seesharp15/cloudline-fan-controller/hardware/pcb/fab/gerbv_copper_bottom.png

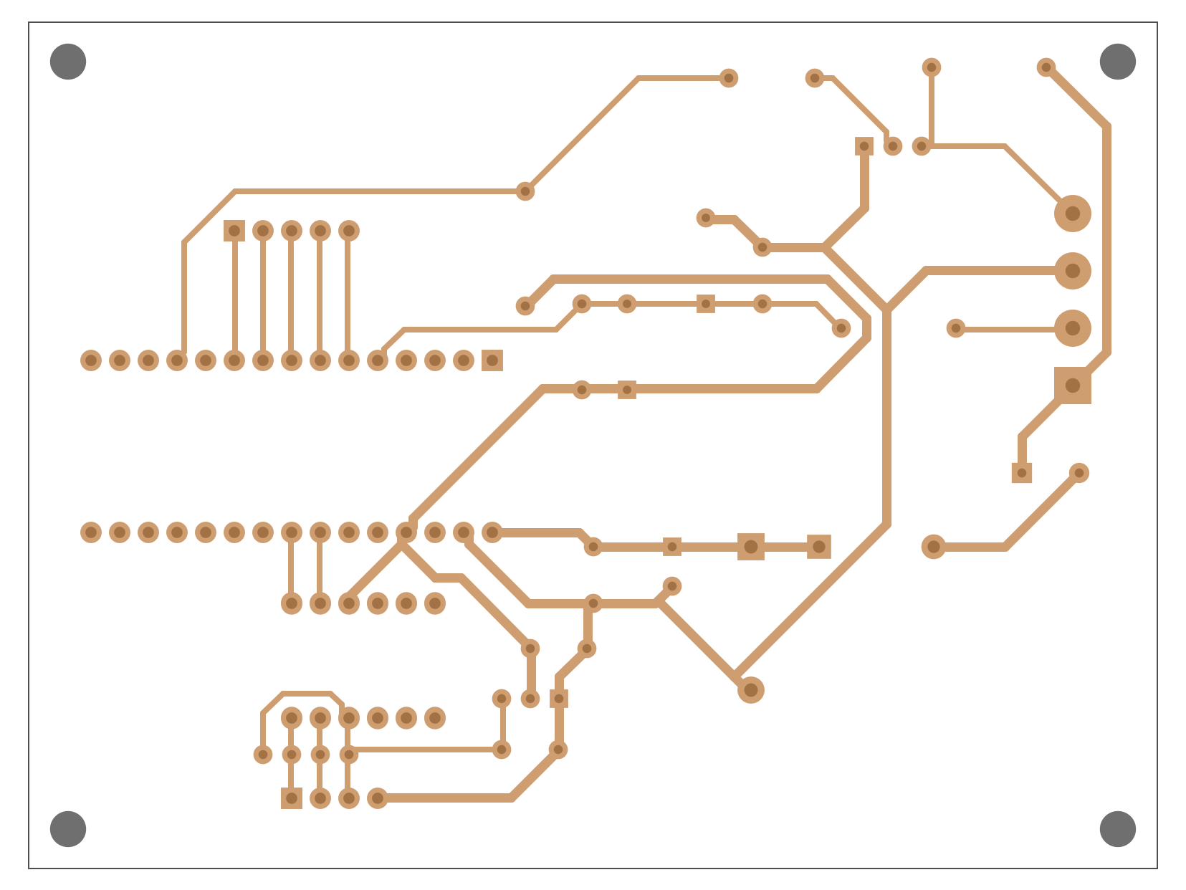
hardware/pcb/fab/gerbv_copper_bottom.png
