seesharp15/cloudline-fan-controller/hardware/pcb/fab/gerbv_silk_top.png

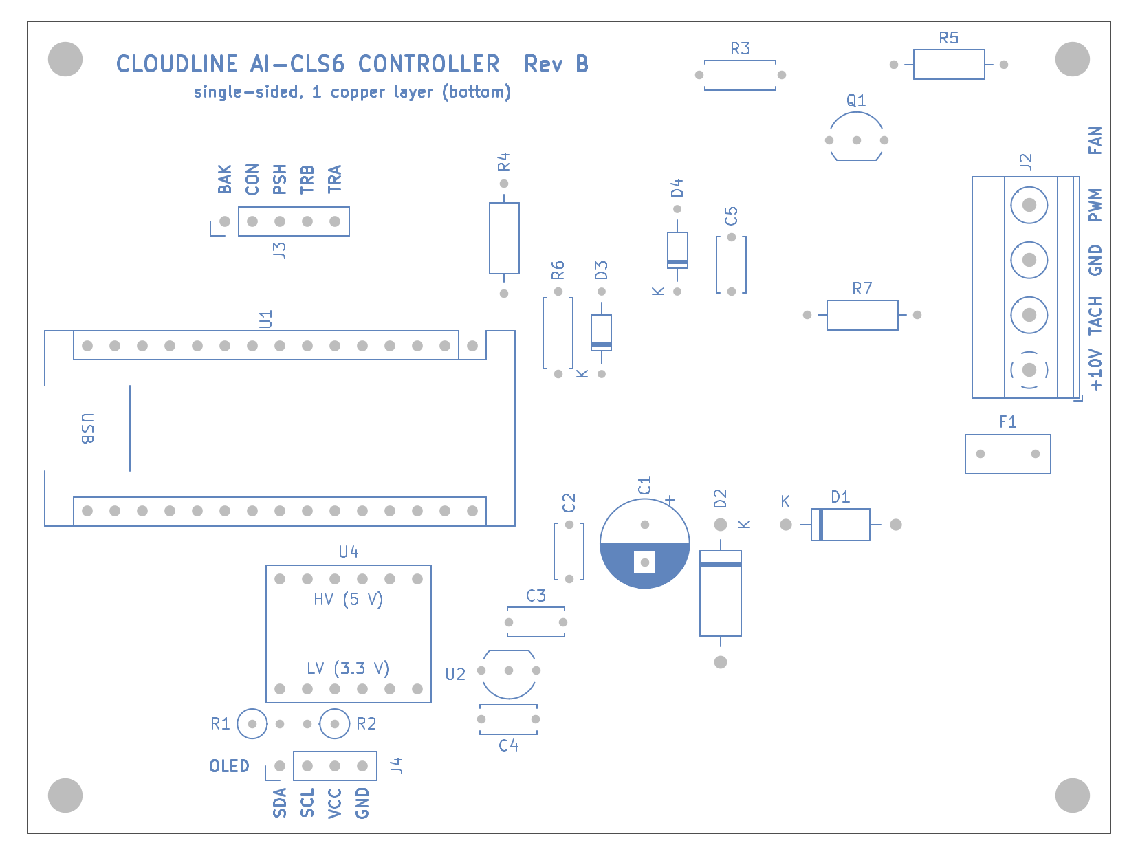
hardware/pcb/fab/gerbv_silk_top.png
