seesharp15/cloudline-fan-controller/hardware/pcb/fusion/isolation_preview.png

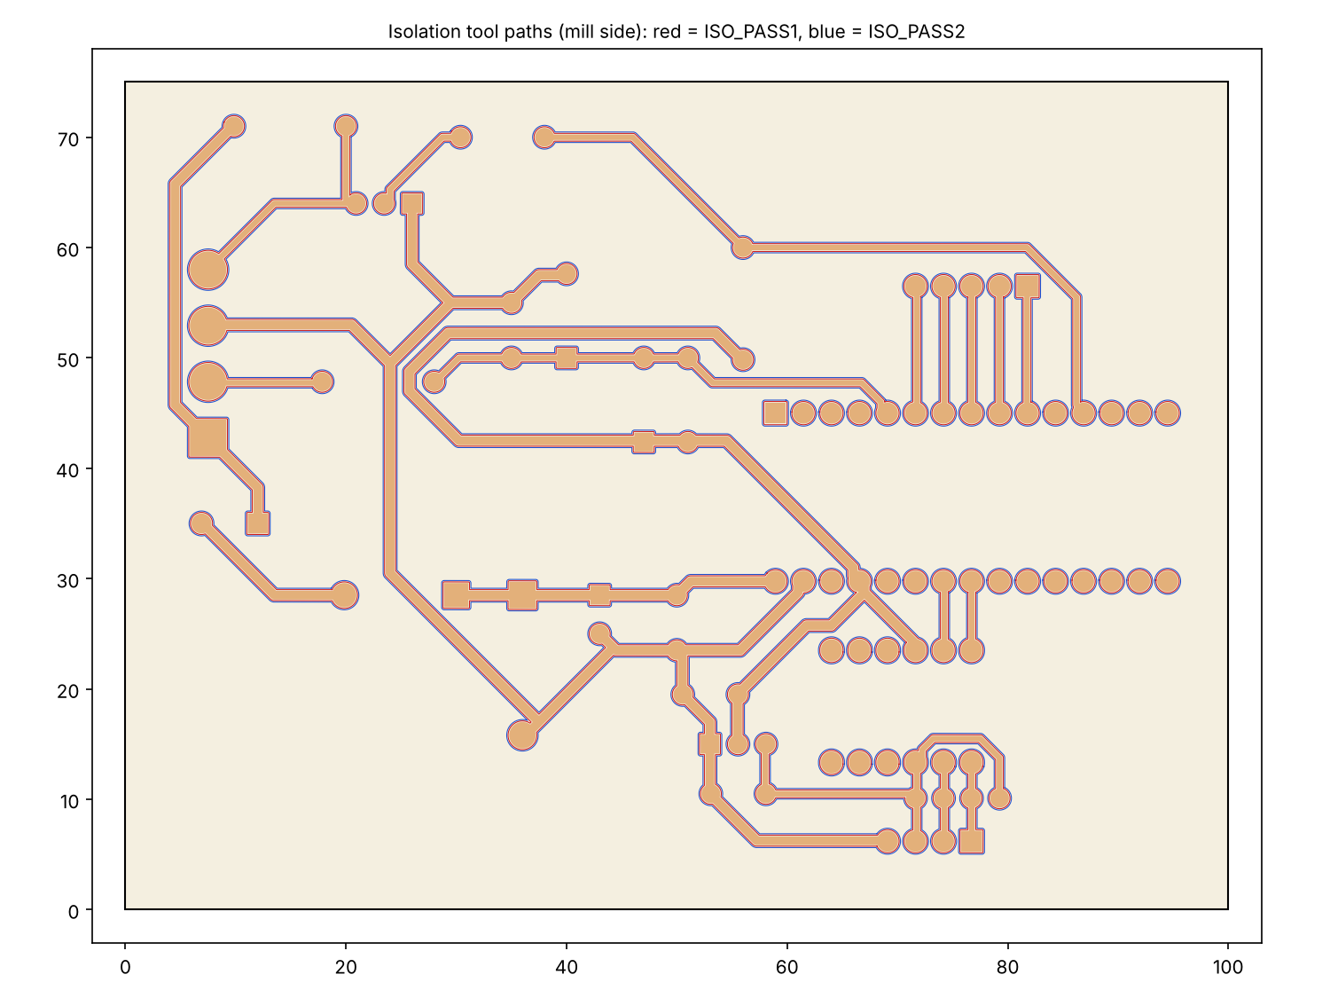
hardware/pcb/fusion/isolation_preview.png
