seesharp15/cloudline-fan-controller/hardware/pcb/fusion/cloudline_pcb_TOPVIEW.step

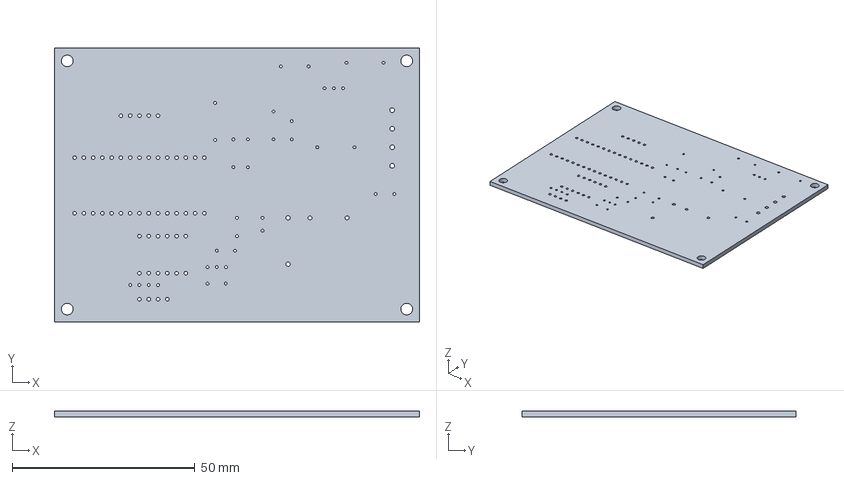
[picture p10: CAD file, 2026-11-03]
hardware/pcb/fusion/cloudline_pcb_TOPVIEW.step
100.0 x 75.0 x 1.64 mm
FR4_substrate
copper_P10V_FAN
copper_P10V_P
copper_P3V3
copper_P5V
copper_nc_U1.11
copper_nc_U1.13
copper_nc_U1.14
copper_nc_U1.15
copper_nc_U1.16
copper_nc_U1.17
copper_nc_U1.18
copper_nc_U1.19
copper_nc_U1.1
copper_nc_U1.20
copper_nc_U1.21
copper_nc_U1.22
copper_nc_U1.25
copper_nc_U1.26
copper_nc_U1.28
copper_nc_U1.2
copper_nc_U1.3
copper_nc_U1.4
copper_nc_U4.GND_HV
copper_nc_U4.GND_LV
copper_nc_U4.HV3
copper_nc_U4.HV4
copper_nc_U4.LV3
copper_nc_U4.LV4
copper_ENC_A
copper_ENC_B
copper_ENC_SW
copper_FAN_PWM
copper_GATE
copper_GND
copper_KEY_BAK
copper_KEY_CON
copper_N_F1_D1
copper_PWM_D9
copper_SCL_3V3
copper_SCL_5V
copper_SDA_3V3
copper_SDA_5V
copper_TACH_5V
copper_TACH_IN
