seesharp15/cloudline-fan-controller/(list of files, cad)

Other CAD files:
hardware/pcb/fusion/cloudline_pcb_MILL_copper_up.step
hardware/pcb/fusion/cloudline_pcb_MILL_copper_up.dxf
