seesharp15/cloudline-fan-controller/hardware/wiring.png

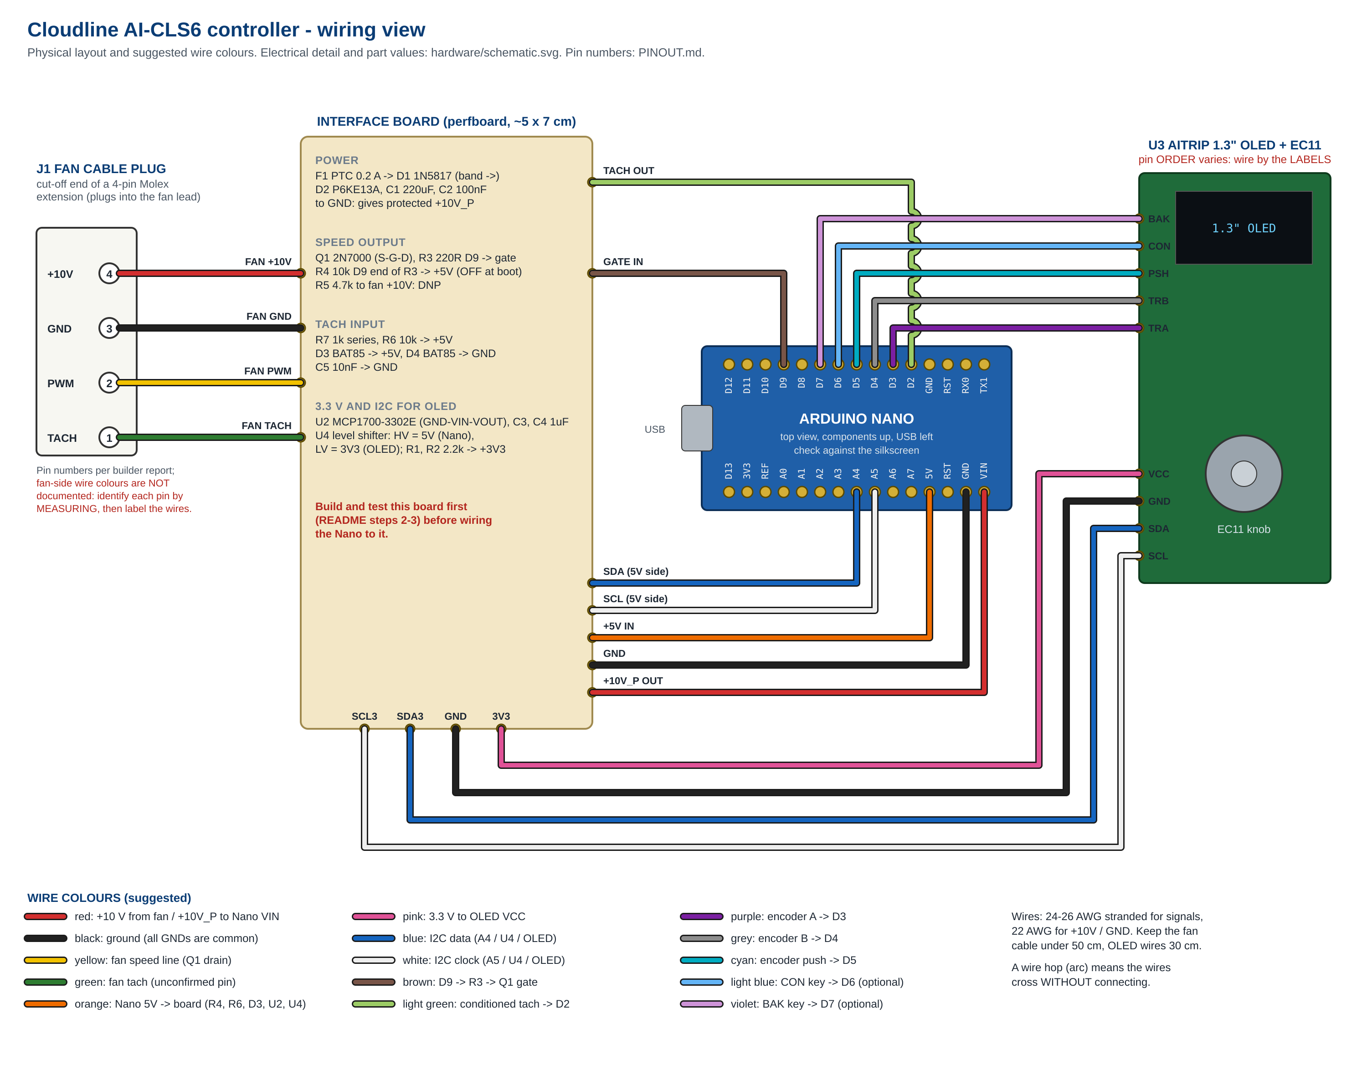
hardware/wiring.png
