seesharp15/cloudline-fan-controller/VERIFICATION.md

# Verification report

What has been checked, how, and what still has to be confirmed on hardware.
Date of this report: 2026-10-28, firmware and hardware **Rev B**.

**Bottom line.** The firmware compiles for the Nano with adequate memory
headroom, its logic passes all host tests, and the real compiled binary boots
and recovers from a hang in an AVR simulator. The circuit values are
calculated below from datasheet limits. **Nothing has been built or run on a
real Nano, OLED module or fan.** The fan-side facts (pinout, signal levels,
tach) come from builder reports, not from AC Infinity, and must be confirmed
with the README's [pre-connection verification](README.md#pre-connection-verification)
and [BENCH_TEST.md](BENCH_TEST.md). This report does not claim the design
will work beyond what that evidence supports.

## Contents

1. [Requirements traceability matrix](#1-requirements-traceability-matrix)
2. [Electrical calculations](#2-electrical-calculations)
3. [Pin assignment cross-check](#3-pin-assignment-cross-check)
4. [Verified versus assumed](#4-verified-versus-assumed)
5. [Hardware assumptions: evidence and status](#5-hardware-assumptions-evidence-and-status)
6. [Known limitations and failure modes](#6-known-limitations-and-failure-modes)
7. [Independent review: findings and fixes](#7-independent-review-findings-and-fixes)
8. [Recorded test and build output](#8-recorded-test-and-build-output)

Requirement IDs: REQ = original brief, DOC = README items, FAQ, ASM =
hardware assumptions (addendum §3), DES = design issues (§4), TST = tests
(§5), VER = this report (§6), SCH = schematic (§7), LAY = layout (§8),
CHK = final checklist (§9). They are deliberately different from part
references (R1, D2, C1 …).

Status legend:

- **PASS**: met and verified by the evidence named (test, compile,
  calculation, inspection).
- **PASS (sim)**: met in software and simulation; hardware confirmation is
  still listed in the "bench" column.
- **HW PENDING**: depends on a fact or behaviour only a physical test can
  confirm.
- **FLAGGED**: cannot be verified from the sources available; documented with
  a procedure for the builder.

---

## 1. Requirements traceability matrix

Code locations are in `firmware/cloudline_controller/` unless a path is
given. "Unit" = `test/test_fan_logic.cpp`, "Sim" = `test/test_firmware_sim.cpp`
scenario, "AVR" = `test/avr/run_simavr.sh`, bench IDs = [BENCH_TEST.md](BENCH_TEST.md).

### 1.1 Original brief (TASK.md)

| ID | Requirement | Code | Schematic | Tests / bench | Status |
|---|---|---|---|---|---|
| REQ-1 | Encoder controls fan speed | `fan_logic.h` `QuadratureDecoder`, `applyDetents`, `Controller::onDetents`; `app.cpp` `ISR(PCINT2_vect)`, `handleEncoder` | U3 TRA/TRB → D3/D4 | Unit `decoder_*`, `detents_*`; Sim `boot1`; bench A6, B4 | PASS (sim) |
| REQ-2 | Encoder button toggles on/off | `fan_logic.h` `Button`, `Controller::onKnob`; `app.cpp` `handleButtons` | U3 PSH → D5 | Unit `button_*`, `controller_on_off_keeps_setting`; Sim `boot1` (incl. bounce); bench A8, B3 | PASS (sim) |
| REQ-3 | Fan off at power-up | `Controller` (`on_ = false`); `app.cpp` `setupFanPwm()` (gate HIGH before OUTPUT), `setup()` | **R4** 10 kΩ, D9 end of R3 → +5V; Q1 | Unit `controller_power_up_state`; Sim `checkPowerUpState` in every scenario; AVR `normal` (duty 0.0 %); bench A4, A5, B1, B2 | PASS (sim); HW PENDING (fan polarity, M4) |
| REQ-4 | Setting persists while powered | `Controller::setting_` (RAM); OFF does not change it | — | Unit `controller_on_off_keeps_setting`; Sim `boot1`, `powercycle`; bench A9, B11 | PASS (sim) |
| REQ-5 | Display: setting and tach speed; on/off status, bars, percentages | `display_ui.h` `drawMain`; `app.cpp` `updateDisplay` | U3 SDA/SCL via U4 | Sim `boot1` text and layout checks on every frame; screenshots `docs/img/`; bench A10, A14, B9 | PASS (sim); ACT % needs a calibration first; tach HW PENDING (ASM-6) |
| REQ-6 | Arduino and OLED powered from the fan's 10 V, with conditioning | — | F1, D1, D2, C1, C2 → VIN; U2, C3, C4 → +3V3 | Calculations §2.1–2.5; bench A1–A3, A13, B1, B10, B13 | PASS (calc); HW PENDING (ASM-2) |
| REQ-7 | Pinout document incl. power supplies | [PINOUT.md](PINOUT.md) §1–§6 | — | `test/check_pins.py` (§3) | PASS |
| REQ-8 | Graphical schematic incl. resistors and transistors | `hardware/schematic.py` → `.svg`/`.png` | all | Inspection (rendered PNG) | PASS |
| REQ-9 | Arduino code | `firmware/cloudline_controller/` | — | Compile §8.4; all tests | PASS |

### 1.2 Addendum §1: README

| ID | Item | Where | Status |
|---|---|---|---|
| DOC-1 | What it does + photo-style overview | README top, `hardware/overview.png` | PASS |
| DOC-2 | BOM: part, qty, value/rating, part number, cost; connectors, wire gauge, heat shrink, enclosure | README *Bill of materials*, `hardware/bom.csv` | PASS |
| DOC-3 | Tools incl. multimeter, USB cable type | README *Tools* | PASS |
| DOC-4 | IDE 2.x, board, pinned library versions, CH340 note, processor setting and how to tell | README *Software setup*, `firmware/libraries.txt` | PASS |
| DOC-5 | Build guide in the required order, each step with a check | README steps 1 verify connector → 2 power conditioning → 3 power test without Nano → 4 OLED/encoder → 5 flash and test on USB → 6 fan interface → 7 first power-up on the fan → 8 enclosure; each ends with "Check before continuing" | PASS |
| DOC-6 | First power-up and expected display | README *Step 7. First power-up on the fan supply* | PASS |
| DOC-7 | Normal operation | README *Normal operation* | PASS |
| DOC-8 | Troubleshooting table with all listed symptoms | README *Troubleshooting* (blank, garbled, encoder skip/backwards, button, full speed when off, won't stop at 0 %, RPM 0/erratic, resets on speed change, upload fails) | PASS |

### 1.3 Addendum §2: FAQ

| ID | Question | Status |
|---|---|---|
| FAQ-1…10 | USB + fan; off at power-up and bootloader window; persistence and how to add it; RPM % and calibration; PWM frequency; other fans; unplugged while running; warranty and damage; Uno/Pro Mini/ESP32; SSD1306 vs SH1106 | PASS: all ten answered in [FAQ.md](FAQ.md), plus six more |

### 1.4 Addendum §3: hardware assumptions

| ID | Assumption | Evidence | Builder check | Status |
|---|---|---|---|---|
| ASM-1 | J1 pinout | §5 ASM-1 | M1, M3, M4, M5 | FLAGGED (builder reports) |
| ASM-2 | Supply voltage and current | §5 ASM-2 | M1, M2 | FLAGGED (voltage reported; current undocumented) |
| ASM-3 | Control signal type, level, frequency; PWM vs 0–10 V | §5 ASM-3 | M3, M4, M4b | FLAGGED (consistent builder reports) |
| ASM-4 | Internal pull-up; floating behaviour | §5 ASM-4 | M3, M3b, M4 | FLAGGED |
| ASM-5 | 0 % stops the fan | §5 ASM-5 | M4, bench B7 | FLAGGED |
| ASM-6 | Tach type, level, PPR | §5 ASM-6 | M5, M5b, bench B5 | FLAGGED (**no source found**) |
| ASM-7 | OLED driver, interface, address | §5 ASM-7 | M7, build step 5 (serial reports the address that answers) | FLAGGED (seller listings) |
| ASM-8 | README pre-connection section with stop rules | README *Pre-connection verification* | — | PASS |

### 1.5 Addendum §4: design issues

| ID | Issue | Code | Schematic | Tests / bench | Status |
|---|---|---|---|---|---|
| DES-1 | Interrupt allocation | `app.cpp` header comment, `onTachPulse` (INT0), `ISR(PCINT2_vect)`; compile-time `#error` checks | D2 tach, D3/D4 encoder | Sim checks INT0 attached, INT1 unused, PCMSK2 = D3/D4; PINOUT §3 | PASS |
| DES-2 | Boot-time fan state, hardware hold-off | `setupFanPwm()` | **R4** 10 kΩ, D9 end of R3 → +5V | Sim `outWhenMadeOutput == HIGH`; calc §2.6; bench A4, A5 | PASS (sim/calc); HW PENDING |
| DES-3 | PWM level shifting into 10 V input; inversion in code | `fan::gateDriveFor`, `FAN_PWM_INVERTED` | **Q1** 2N7000, **R3** 220 Ω, R4, R5 (DNP) | Unit `gate_drive_*`, `polarity_inversion`; Sim duty checks; bench A7 | PASS (sim/calc); HW PENDING (M4) |
| DES-4 | Tach pulled up to 5 V, protected | `onTachPulse` (FALLING); D2 `INPUT_PULLUP` | **R6** 10 kΩ → +5V, **R7** 1 kΩ, **D3/D4** BAT85, **C5** 10 nF | Calc §2.7; README step 6 check (tach node 4.5–5.1 V, 0.45 V when shorted); bench A10, A11 | PASS (calc); HW PENDING |
| DES-5 | Power: VIN regulator vs buck, dissipation at 10 V, reverse polarity, bulk/decoupling, transients, brown-out | — | F1, D1, D2, C1, C2 | Calc §2.2–2.5; FAQ; bench A1–A3, A13, B10 | PASS (calc); HW PENDING |
| DES-6 | Encoder: state machine, no skip/reverse, step and range | `QuadratureDecoder`, `applyDetents`, `ENC_*`, `SETTING_*` in `config.h` | — | Unit `decoder_*` (bounce, rapid reversal, half-step), `detents_at_limits`; Sim bounce | PASS (sim) |
| DES-7 | Button: debounced, one toggle per press | `fan::Button` (25 ms) | — | Unit `button_bounce_gives_one_press`; Sim bounce block in `boot1`; bench A8 | PASS (sim) |
| DES-8 | RPM: window, timeout, % vs calibrated max, calibration method | `TachEstimator`, `smoothRpm`, `rpmToPercent`, `tachFault`, `Controller` calibration; serial `c`/`m` | — | Unit `tach_*`, `rpm_percent*`, `controller_calibration_*`; Sim `boot1`, `calfail`, `serial`; bench A10–A12, B8 | PASS (sim) |
| DES-9 | Display: no flicker, stated rate, layout | `updateDisplay` (10 Hz + on input), page buffer | — | Sim: 95–105 frames per 10 s, layout checks; bench A14 | PASS (sim); flicker HW PENDING |
| DES-10 | Setting in RAM only; no EEPROM writes | no EEPROM code anywhere | — | `make -C test` `no-eeprom`; `avr-nm` shows no EEPROM routines linked (§8.4); Sim `powercycle` | PASS |
| DES-11 | Watchdog; documented reset behaviour | `watchdogStart` (started at the top of `setup()`), `ISR(WDT_vect)` (fan off, interrupt sources off, setting saved, `jmp 0`), `earlyResetHandling` (`.init3`) | R4 keeps fan off during any reset | AVR `hang` (recovery, fan off, setting 37 % kept, `reset=0x80`); Sim feed count; FAQ; bench W1, W2 | PASS (AVR sim); interrupts-off path per datasheet, HW PENDING (W2) |
| DES-12 | Every tunable in a labelled config block | `config.h`, a separate tab included first by the sketch, headed "CONFIGURATION BLOCK" (the addendum says "at the top of the sketch"; a separate file keeps it the only file to edit, and §8 lists "sketch, config" separately) | — | Inspection | PASS (as a separate file) |

### 1.6 Addendum §5–§9

| ID | Item | Evidence | Status |
|---|---|---|---|
| TST-1 | Pure logic separated from hardware | `fan_logic.h` has no Arduino calls; `app.cpp` glue only | PASS |
| TST-2 | Host unit tests incl. listed edge cases | `test/test_fan_logic.cpp`: encoder at min/max (`detents_at_limits`), rapid direction changes, button bounce, tach timeout, divide-by-zero, max RPM not calibrated | PASS |
| TST-3 | Tests run, output included | §8.1–8.3 | PASS |
| TST-4 | arduino-cli compile with flash/RAM; RAM headroom | §8.4; §2.11 | PASS |
| TST-5 | Wokwi simulation, can/can't | `sim/`; [sim/README.md](sim/README.md). **Not run**: wokwi.com unreachable from the build environment; stated in sim/README. | PARTIAL (prepared, compiles, not executed) |
| TST-6 | BENCH_TEST.md, dummy load then real fan | [BENCH_TEST.md](BENCH_TEST.md) Parts A and B | PASS |
| TST-7 | State what is not possible | sim/README (Wokwi not run), §4, test/avr/README (simavr watchdog limit) | PASS |
| VER-1…6 | This report: matrix, calculations, pin cross-check, verified vs assumed, limitations, review findings | §1–§7 | PASS |
| SCH-1 | Schematic SVG + PNG from editable source | `hardware/schematic.py` → `schematic.svg`, `schematic.png` | PASS |
| SCH-2 | Ref + value on every part; connector pins from mating side, side stated | schematic; J1 face view box | PASS |
| SCH-3 | Wiring view with wire colours | `hardware/wiring.svg/.png` | PASS |
| LAY-1 | Repository layout | README *Development and tests* | PASS |
| CHK-1 | Final checklist | end of the delivery message | PASS |

### 1.7 Single-sided PCB (request of 2026-11-03)

| ID | Item | Evidence | Status |
|---|---|---|---|
| PCB-1 | PCB with only one copper trace layer | `hardware/pcb/cloudline_controller.kicad_pcb`: every track and pad on B.Cu, no wire links; F.Cu is KiCad's (empty) *jumper* layer and is not exported | PASS |
| PCB-2 | Realises the schematic | `hardware/pcb/check_pcb.py`: copper-geometry connectivity vs. PINOUT §6, 20 nets / 71 pads, 0 opens / 0 shorts (mutation-tested) | PASS |
| PCB-3 | Manufacturable | KiCad DRC: 0 errors, 0 unconnected (22 intentional library-mismatch warnings); gerbv reads the Gerbers back; independent review: no blockers, findings fixed (below) | PASS (not yet fabricated) |
| PCB-4 | All files for production | `hardware/pcb/fab/`: Gerber + drill zip with `FAB_NOTES.txt`, drill map, BOM, assembly drawing, toner-transfer artwork; ordering options in `hardware/pcb/README.md` | PASS |

**Independent review of the PCB (2026-11-03).** A separate agent reviewed the
board, the footprints against the real parts (pin orders, polarities, lead
pitches, the BOB-12009 against SparkFun's Eagle file), the mechanics, the
fab package and the documentation. It confirmed:

- the Nano pin mapping;
- the TO-92 and diode orientation, and C1's polarity;
- the BOB-12009 footprint;
- all lead pitches except F1's;
- the J2/J3/J4 labels against their nets;
- the J2 wire-entry direction;
- the clearances and the fab layers.

It found no blockers. Its findings were:

| # | Sev. | Finding | Resolution |
|---|---|---|---|
| P-1 | Major | The 100 × 75 mm board doesn't fit the enclosure in the BOM, and the BOM and README gave different box sizes. | No inside dimensions could be verified for the listed box, so the BOM and README now state the required **inside** size (115 × 90 × 35 mm for the PCB) and standoff mounting through the board's own holes. |
| P-2 | Major | A 1-layer order doesn't tell the fab that the copper is on the bottom and the legend on top; the file attributes said "L2" and "Plated". | `FAB_NOTES.txt` in the zip, order-remark text in the PCB README, attributes rewritten to `Copper,L1,Bot` and `NonPlated`. |
| P-3 | Minor | Wire link W1 only grounded U4's GND, which the BOB-12009 doesn't use (its GND pins connect only to each other in SparkFun's board file). | U4's GND left unwired; **the board now has no wire links**. |
| P-4 | Minor | F1 footprint (Bel Fuse 0ZRE) has its second pad offset 1.6 mm sideways; the MF-R020 has straight leads. | New `PTC_Radial_P5.10mm` footprint, pads 5.1 mm apart in line. |
| P-5 | Minor | TO-92 footprints have 2.54 mm pitch; straight-lead parts have 1.27 mm. | Assembly note and BOM note: bend the outer leads out. |
| P-6 | Minor | Connector pin labels 0.8 mm / 0.12 mm stroke, below typical fab minimums. | 1.0 mm, 0.16 mm stroke. |
| P-7 | Minor | J4's label was one string beside pin 4. | One label per pin, as on J3. |
| P-8 | Minor | J2 pads (2.6 mm) on unplated holes may lift under screw torque. | 3.3 mm pads; cable gland recommended. |
| P-9 | Minor | PCB README errors: `check_pins.py` doesn't read the PCB; the assembly drawing had no pads; "R4 bridges tracks" was untrue; Adafruit 757 offered without a footprint check. | All corrected; the assembly drawing now includes the pads (B.Mask). |

After these fixes the board was regenerated and DRC, `check_pcb.py`, the
host tests and the fab package were re-run (results above). The fixes were
not reviewed again by a separate agent.

---

## 2. Electrical calculations

Datasheet values are the manufacturers' limits for the parts in the BOM.
"Typ" means a typical figure; worst cases use the limits.

### 2.1 Current budget (+10 V input)

| Load | Current | Basis |
|---|---|---|
| ATmega328P, 16 MHz, 5 V, active | ≈ 10 mA | Datasheet active-supply-current curve (~9–12 mA) |
| CH340 USB chip (idle, no USB) | 3–15 mA | Varies by clone; estimate |
| Nano power LED | ≈ 3 mA | 5 V through ~1 kΩ |
| D13 LED (fan ON) | ≈ 3 mA | 5 V through ~1 kΩ |
| OLED module | 5–20 mA | Depends on lit pixels (these screens light ~20–35 %); estimate |
| R4 (D9 low, fan running) | 0.5 mA | 5 V / 10 kΩ |
| R6 (tach low) | ≤ 0.5 mA | 5 V / 11 kΩ |
| R1/R2 (I²C low) | ≤ 1.5 mA each, while bits are low | 3.3 V / 2.2 kΩ |
| U4 module pull-ups (I²C low) | ≤ 0.8 mA per line, while bits are low | 10 kΩ to 5 V and to 3.3 V |
| U2 quiescent | 1.6 µA | MCP1700 datasheet |
| **Total** | **≈ 25–55 mA; design figure 60 mA** | |

### 2.2 Input chain

- **F1** Bourns MF-R020: hold 0.20 A, trip 0.40 A, 60 V. Resistance a few
  ohms (rises after a trip). At 60 mA: drop 0.1–0.5 V. Normal load is under
  a third of the hold current, which leaves room for derating at 40–50 °C.
- **D1** 1N5817: V<sub>RRM</sub> 20 V (> 10 V, so reverse polarity is
  blocked), forward drop ≈ 0.3 V at 60 mA (datasheet V<sub>F</sub> curve).
- **VIN** = 10 − (0.1…0.5) − 0.3 ≈ **9.2–9.6 V** at full load; the README
  uses "M1 minus 0.2–0.7 V".
- **D2** P6KE13A: V<sub>RWM</sub> 11.1 V (no conduction at 10 V; leakage
  ≤ 5 µA), V<sub>BR</sub> 12.4–13.7 V, clamps short surges. A sustained
  over-voltage makes it conduct hard so F1 trips (0.4 A).
  **Caveat:** its clamping voltage at high surge current (18.2 V at 33 A)
  is above the AMS1117's 15 V absolute maximum (clone Nanos); genuine Nanos
  use regulators rated to 20 V. A surge of that size from a fan's internal
  10 V supply through F1 and the cable is not expected; this is a residual
  risk, not a calculated margin.
- **C1** 220 µF / 25 V: bulk and hold-up (§2.4). **C2** 100 nF at VIN:
  high-frequency decoupling.

### 2.3 Regulator dissipation (Nano 5 V regulator) — at 10 V input

Worst case taken literally at **10 V on VIN** (ignoring the D1/F1 drops):

P = (V<sub>IN</sub> − 5 V) × I = (10 − 5) × 0.060 = **0.30 W**
(0.28 W at the realistic 9.6 V).

The regulator is an AMS1117-5.0 (clones) or LM1117 (genuine) in SOT-223.
With the Nano's small copper area, θ<sub>JA</sub> ≈ 90–110 °C/W (datasheet
range for minimum pad), so the rise is **27–33 °C**: T<sub>J</sub> ≈ 73 °C
at 40 °C ambient, against a 125 °C maximum. Dropout ≈ 1.1–1.2 V, so it
regulates down to **V<sub>IN</sub> ≈ 6.2 V**.

**Buck vs linear:** a buck at ~85 % efficiency would take about 0.35 W
instead of 0.6 W from the fan, saving ~0.25 W, but adds switching noise next
to the tach input and another module. The linear regulator is within limits,
so it was kept (FAQ). Above ~100 mA or 12 V input a buck would be preferable.

**U2** MCP1700-3302E: (5 − 3.3) × 0.020 = 34 mW; V<sub>IN</sub> max 6 V
(> 5 V rail); dropout 178 mV typ at 250 mA; needs ≥ 1 µF ceramic in and out
(C3, C4).

### 2.4 Hold-up and brown-out

- D1 stops C1 discharging back into the fan's supply when it dips.
- Time C1 can hold the regulator in regulation at 60 mA, from 9.6 V down to
  6.2 V: t = C × ΔV / I = 220 µF × 3.4 V / 0.060 A = **12.5 ms**.
- If the 5 V rail does collapse, the ATmega's brown-out detector (Nano
  fuses: extended 0xFD = BOD 2.7 V) holds it in reset; D9 floats and R4
  keeps Q1 on while the rail is above Q1's threshold (§2.6). Below about 3 V
  on the 5 V rail Q1 can't be held on and the fan line is released: this
  requires the fan's own 10 V to have collapsed below ~4 V (bench A13).

### 2.5 Reverse polarity and transients summary

| Event | Result |
|---|---|
| J1 +10 V / GND swapped | D1 blocks (20 V rating). No current. |
| Spike on +10 V | D2 clamps; C1/C2 absorb short ones |
| Sustained over-voltage > 12.4 V | D2 conducts, F1 trips at ≥ 0.4 A, resets when it cools |
| Controller short | F1 limits to < 0.4 A sustained |

### 2.6 Speed output: Q1 2N7000 (open drain)

| Quantity | Value | Basis |
|---|---|---|
| Gate drive | V<sub>GS</sub> = 5 V (D9 high, or R4 during reset) | ATmega V<sub>OH</sub> ≥ 4.2 V at 20 mA; static gate current ≈ 0 |
| Threshold | V<sub>GS(th)</sub> 0.8–3.0 V | onsemi 2N7000 datasheet |
| On-resistance | R<sub>DS(on)</sub> ≤ 5.3 Ω at V<sub>GS</sub> 4.5 V | onsemi datasheet |
| Line current | I = V<sub>pull-up</sub> / R<sub>pull-up</sub> ≤ 10 V / 1 kΩ = 10 mA (M3b measures R) | |
| Line "low" | V<sub>DS</sub> ≤ 10 mA × 5.3 Ω = **53 mV** | "Stopped" level |
| Q1 dissipation | ≤ 0.5 mW | |
| D9 peak current | 5 V / (220 Ω + ~25 Ω pin) ≈ **20 mA** < 40 mA abs. max | R3 |
| Gate time constant | 245 Ω × C<sub>iss</sub> ≤ 60 pF ≈ **15 ns** | ≪ 250 µs period at 4 kHz |
| R4 current while D9 low | 5 V / 10 kΩ = 0.5 mA | |
| R5 (if fitted) | 10 V / 4.7 kΩ = 2.1 mA, 21 mW | |
| Line duty (inverted) | gate duty = 1000 ‰ − line duty | `gateDriveFor` |
| PWM | Timer1 mode 14, TOP = 16 MHz / 4 kHz − 1 = 3999 → **4000 Hz, 4000 steps** | Sim checks ICR1 = 3999 |
| Line rise time | τ = R<sub>pull-up</sub> × C<sub>line</sub>; e.g. 100 kΩ × 300 pF = 30 µs (12 % of a period) | Unknown R: M3b |

### 2.7 Tach input (5 V pull-up, series resistor, clamps)

ATmega328P at 5 V: **V<sub>IL</sub> max = 0.3 V<sub>CC</sub> = 1.5 V,
V<sub>IH</sub> min = 0.6 V<sub>CC</sub> = 3.0 V**; inputs have Schmitt
triggers.

| Fan's tach pin state | D2 voltage | Margin |
|---|---|---|
| Open collector sinking (V<sub>CE(sat)</sub> ≤ 0.4 V) | 0.4 + 4.6 × 1k/11k = **0.82 V**; with the AVR's internal pull-up (≥ 20 kΩ) also on, R6‖20k = 6.7 kΩ: 0.4 + 4.6 × 1k/7.7k = **1.0 V** worst case | ≥ 0.5 V below V<sub>IL</sub> |
| Open collector released | 5.0 V through R6 | 2.0 V above V<sub>IH</sub> |
| Push-pull 3.3 V high | 3.3 + 1.7 × 1k/11k = **3.45 V** | 0.45 V above V<sub>IH</sub> |
| Push-pull 10–12 V high | clamped by D3 to ≈ 5.3 V; current (12 − 5.3) / 1 kΩ = **6.7 mA** | BAT85 I<sub>F</sub> max 200 mA; the 5 V rail's ≥ 25 mA load absorbs it |
| Negative spike | clamped by D4 to ≈ −0.3 V | |
| Nothing connected | 5.0 V; no edges; NO TACH after 8 s | |

- Filter: R6‖R7 ≈ 0.91 kΩ × 10 nF ≈ **9 µs** on falling edges; release
  (rising) through R6: 10 kΩ × 10 nF = 100 µs, reaching V<sub>IH</sub> in
  ≈ 92 µs. Tach periods are milliseconds (up to 1 kHz is accepted:
  `TACH_MIN_PERIOD_US` 1000 = 30 000 RPM at 2 PPR).
- Firmware: falling edges on INT0, glitch rejection < 1 ms, RPM from period
  over a 500 ms window, 0 RPM after 1.5 s without edges. D2 also has the
  AVR's internal pull-up on, so it is defined before R6 is fitted (build
  step 5).

### 2.8 I²C and module inputs

The ATmega328P's two-wire interface needs **V<sub>IH</sub> ≥ 0.7 V<sub>CC</sub>
= 3.5 V** (datasheet, two-wire serial interface characteristics), stricter
than the 0.6 V<sub>CC</sub> of general I/O. A 3.3 V pull-up therefore does not
meet the datasheet, and a 5 V pull-up would put 5 V on the SH1106 (V<sub>DD</sub>
3.3 V). Rev B adds **U4**, a BSS138 bidirectional level shifter (SparkFun
BOB-12009: one BSS138 per channel, 10 kΩ pull-ups to HV and LV):

| Side | Pull-up | High level | Low level | Rise time (30→70 %) |
|---|---|---|---|---|
| Nano (HV, 5 V) | U4 10 kΩ ‖ AVR internal 20–50 kΩ ≈ 7 kΩ | 5 V ≥ 3.5 V ✓ | via BSS138 from the LV side, < 0.4 V | short on-board wires, ~20 pF: 0.85 × 7 kΩ × 20 pF ≈ **120 ns** |
| Display (LV, 3.3 V) | R1/R2 2.2 kΩ ‖ U4 10 kΩ ≈ 1.8 kΩ (‖ module pull-ups, if any) | 3.3 V | SH1106 or BSS138; the device pulling low also sinks the 5 V side's pull-up current through the BSS138: 3.3 V / 1.8 kΩ + 5 V / 7 kΩ ≈ **2.5 mA** (I²C limit 3 mA). With extra ≤ 4.7 kΩ pull-ups on the module it would be ≈ 3.2 mA, so R1/R2 are left out in that case (README M7). | module wires, ~100 pF: 0.85 × 1.8 kΩ × 100 pF ≈ **150 ns** |

Both are below the 300 ns fast-mode limit at the 400 kHz clock. (Rev A had
4.7 kΩ to 3.3 V directly on the Nano pins: ≈ 400 ns and a 3.3 V high
below V<sub>IH</sub>; review finding 6 and self-found S-1.)

The `Wire` timeout is enabled in `setup()` (25 ms, with TWI reset), so a
single transfer can't block. A stuck bus would still make a whole display
operation slow (U8g2's `begin()` is ~165 transfers ≈ 4 s of timeouts, more
than the 2 s watchdog), so the firmware drives the display **only while it
answers**: `startDisplay()` probes the address first (one 25 ms timeout at
most) and skips `begin()` if there's no answer; each page of a frame is
followed by a timeout check that stops drawing after at most one page
(8 transfers ≈ 200 ms); the display is probed again every 5 s. The timeout's
TWI reset re-enables the AVR's internal 5 V pull-ups, which is harmless on
U4's 5 V side. Sim scenario `nodisplay` covers a missing display, a late
display and a mid-run bus failure.

Encoder/keys: switches to GND with the AVR's 5 V internal pull-ups; assumed
not to connect to the SH1106 (README check M7).

### 2.9 Timing and CPU load

- Display: page buffer, 4 passes per frame, 1 KB at 400 kHz ≈ 25–30 ms per
  frame (estimate). 10 Hz refresh ≈ 30 % of the time. Encoder and tach are
  interrupt-driven, so no edges are lost during transfers.
- Worst `loop()` pass, display working: ≈ one frame (< 50 ms). Display
  failing: one page of timeouts (≈ 200 ms) once, then 25 ms probes every
  5 s. Both ≪ 2 s watchdog.

### 2.10 Logic level summary

| Signal | Driver | Receiver | Levels |
|---|---|---|---|
| D9 → Q1 gate | ATmega 0/5 V | 2N7000 V<sub>th</sub> ≤ 3 V | 5 V ≥ 3 V + margin |
| Q1 drain → fan | open drain | fan input (pull-up to ~10 V) | 0.05 V / released |
| Fan tach → D2 | OC or push-pull | ATmega Schmitt input | ≤ 0.82 V / ≥ 3.45 V |
| SDA/SCL, Nano side | open drain, 5 V pull-ups (U4 HV) | ATmega TWI (V<sub>IH</sub> 3.5 V) | 0 / 5 V |
| SDA/SCL, display side | open drain, 3.3 V pull-ups (R1/R2, U4 LV) | SH1106 | 0 / 3.3 V |
| Encoder/keys → D3–D7 | switch to GND | ATmega + 5 V internal pull-up | 0 / 5 V |

### 2.11 Memory

| | Used | Limit | Headroom |
|---|---|---|---|
| Flash | 26 236 B | 30 720 B | 4 484 B (15 %) |
| Static RAM | 1 287 B | 2 048 B | 761 B for stack |
| Stack, estimated | ≈ 360 B | | deepest path: `loop` 11 + `updateDisplay` 56 + `drawDiagnostics` 67 + `vfprintf` + U8g2 + one ISR frame (`-fstack-usage`) |
| Stack, measured | min. 561 B never touched | | simavr run with the display code forced on, main screen (§8.3) |

The full 1 KB frame buffer was tried first and **does not fit** (2 044 B
static, 4 B left): the firmware uses the 256-byte page buffer
(`OLED_PAGE_BUFFER 1`).

---

## 3. Pin assignment cross-check

`python3 test/check_pins.py` (also run by `make -C test`) parses
`config.h`, `hardware/schematic.py` (Nano pin labels, physical numbers and
the wires to the module), `hardware/wiring.py`, PINOUT.md and README.md, and
fails on any disagreement. A deliberate mutation (D4 → 8 in `config.h`) was
detected. Result: **72 checks, 0 mismatches** (§8.5).

| Signal | Nano pin (physical) | config.h | PINOUT.md | Schematic | Wiring view | README |
|---|---|---|---|---|---|---|
| Tach | D2 / INT0 (5) | `PIN_TACH 2` | ✓ | ✓ D2 / INT0, 5 | ✓ green → D2 | ✓ Step 6 |
| Encoder A | D3 (6) | `PIN_ENC_A 3` | ✓ TRA | ✓ wired to TRA | ✓ purple TRA → D3 | ✓ Step 4 |
| Encoder B | D4 (7) | `PIN_ENC_B 4` | ✓ TRB | ✓ wired to TRB | ✓ grey TRB → D4 | ✓ Step 4 |
| Push switch | D5 (8) | `PIN_ENC_SW 5` | ✓ PSH | ✓ wired to PSH | ✓ cyan PSH → D5 | ✓ Step 4 |
| CON key | D6 (9) | `PIN_KEY_CON 6` | ✓ CON | ✓ wired to CON | ✓ light blue → D6 | ✓ Step 4 |
| BAK key | D7 (10) | `PIN_KEY_BAK 7` | ✓ BAK | ✓ wired to BAK | ✓ violet → D7 | ✓ Step 4 |
| Fan PWM | D9 / OC1A (12) | `PIN_FAN_PWM 9` | ✓ | ✓ D9 / OC1A, 12 | ✓ brown → D9 | ✓ Step 6 |
| Status LED | D13 (16) | `PIN_STATUS_LED 13` | ✓ | on-board (note) | — | — |
| SDA | A4 (23) → U4 HV1/LV1 → module SDA | fixed TWI | ✓ | ✓ A4 / SDA, 23, via U4 | ✓ blue → A4, board → SDA | ✓ Step 4 |
| SCL | A5 (24) → U4 HV2/LV2 → module SCL | fixed TWI | ✓ | ✓ A5 / SCL, 24, via U4 | ✓ white → A5, board → SCL | ✓ Step 4 |
| VIN | VIN (30) | — | ✓ | ✓ 30 | ✓ red → VIN | ✓ Step 2 |
| +5V | 5V (27) | — | ✓ | ✓ 27 | ✓ orange → 5V | ✓ Step 4 |
| GND | GND (29, 4) | — | ✓ | ✓ 29, 4 | ✓ black → GND | ✓ Step 2 |
| J1 pins | 4 +10V, 3 GND, 2 PWM, 1 TACH | — | ✓ | ✓ | ✓ | ✓ M1–M5 |

D8 (`PIN_SIM_TACH_OUT`) is used only in the Wokwi build and appears only in
PINOUT.md, config.h and `sim/diagram.json`.

---

## 4. Verified versus assumed

### Verified

| What | How |
|---|---|
| Firmware compiles for the Nano (both processor settings) and for Wokwi, no warnings from project files | arduino-cli 1.1.1, ArduinoCore-avr 1.8.6, avr-gcc 7.3.0, U8g2 2.35.30 (§8.4) |
| Flash and RAM fit, with stack headroom | size report; `-fstack-usage`; simavr stack paint (§2.11) |
| No EEPROM code | grep check and `avr-nm` of the linked ELF |
| Logic: encoder, button, duty mapping, inversion, Timer1 values, tach maths, timeout, % and guards, controller state machine, calibration, serial parser | 1 113 unit checks, C++11 and C++17 (§8.1) |
| Whole sketch behaviour, screen content and layout, power-up state, millis() wrap | 8 simulation scenarios, 1 451 checks, 1 225 frames layout-checked (§8.2) |
| Real AVR binary boots, prints status, keeps the fan at 0 %; watchdog-interrupt recovery with the fan forced off and the setting kept | simavr (§8.3) |
| Pin numbers agree in all documents | `check_pins.py` (§3) |
| Watchdog second-timeout reset when the interrupt can't run | ATmega328P datasheet (WDTCSR bit WDIE); **not** reproducible in simavr |
| Circuit values against part limits | §2 calculations from datasheet figures |

### Assumed: must be confirmed on hardware

| Assumption | Confirmed by |
|---|---|
| J1 pin functions (4 = +10 V, 3 = GND, 2 = PWM, 1 = tach?) | M1, M3–M5 |
| The port supplies ≥ 60 mA without sagging | M2, bench B1, B13 |
| Line low = stop, released = full; open-drain at 4 kHz works | M4, bench B3, B4, B7 |
| A tach exists on pin 1, its type and pulses per revolution | M5, bench B5 (no published source) |
| Module is SH1106, I²C 0x3C, works on 3.3 V; encoder pins are plain switches | M7, build step 5 (serial address report) |
| EC11 is 20 pulses / 20 detents (4 edges per click) | build step 5 |
| The real display has no visible flicker with the page buffer | bench A14 |
| Brown-out behaviour with the real fan supply | bench A13, B10 |
| Length of the power-up window before R4 can hold Q1 on (FAQ) | bench A4 (scope), B2 |
| U4 level shifter at 400 kHz with the real wiring | build step 5 |
| Thermal behaviour in the enclosure | bench B13 |
| Wokwi diagram runs as described | not run (sim/README) |

---

## 5. Hardware assumptions: evidence and status

Each assumption, the best evidence found, and the builder's check. Sources
are linked in the README *Sources* section. "Builder report" means a hobbyist
forum post or repository, not a manufacturer document.

### ASM-1. Connector and pinout

- **Assumption:** the control port is a PC-peripheral-style 4-pin "Molex"
  (8981 family, 5.08 mm), **not** a 4-pin PC fan header. Pin 4 = +10 V,
  3 = GND, 2 = PWM (speed), 1 = tach (unconfirmed), numbered left to right
  with the chamfered corners up, looking at the fan lead.
- **Evidence:** RollItUp T6/Hyperfan thread (pin 4 = +10 VDC, 3 = GND,
  2 = PWM, 1 = "not used"; chamfer up, left to right); chriskoz/AutoFan for
  the S6 ("4-pin molex ATX HDD connector", "10V / GND / PWM", 4th pin N/C);
  RollItUp ESP32 guide ("same Molex connector used in PC's power supply to
  disks"); AC Infinity manual (fan has "a molex connector"). The 5.08 mm
  pitch follows from the connector family, not from a source.
- **Caveat:** newer S6 units and the PRO line use a USB-C ("UIS") port with
  a different pinout (coofercat/ha-ac-infinity-fan).
- **Check:** M1 (supply and ground, mirror numbering if negative), M3, M4,
  M5. Wire colours are not documented: identify by measuring.

### ASM-2. Supply voltage and current

- **Assumption:** ~10 V DC on pin 4; enough current for ~60 mA.
- **Evidence:** voltage: several builder reports ("10V source ... provided
  by the CL itself", "the fan's 10V instead of 12V ... enough to power the
  Shelly and a few LEDs"). Current: **no source**; one builder reports
  trouble when several channels were powered from it.
- **Check:** M1 (9.5–10.5 V), M2 (≤ 0.5 V drop at 45 mA). Fallback: separate
  adapter (FAQ).

### ASM-3. Control signal

- **Assumption:** PWM by pulling an internally pulled-up ~10 V line to
  ground (open drain); not 0–10 V analogue. Stock controller ≈ 4 kHz.
- **Evidence:** chriskoz ("controlled by grounding and opening the 10V
  control wire", period ~245 µs); ESPHome builds with `inverted: true` and a
  MOSFET to GND at 1 kHz; coofercat (~5 kHz on the USB-C model).
- **If it is actually 0–10 V analogue:** an analogue input would respond to
  the average voltage, which the open-drain PWM also provides; if a fan
  needed a smooth DC level, an RC filter (e.g. 10 kΩ + 10 µF) after Q1's
  drain would be added. Detect: M4 behaves the same; bench A7 levels.
- **Check:** M3, M4.

### ASM-4. Internal pull-up and floating behaviour

- **Assumption:** pulled up inside the fan to about its supply voltage; the
  fan runs at full speed when the line floats.
- **Evidence:** chriskoz ("pulled up to 10V by the fan"). Floating = full
  speed is an **inference** (released line = 100 % duty), not a report.
- **Check:** M3 (voltage), M3b (strength), M4 (released = full). If it
  floats, fit R5.

### ASM-5. Does 0 % stop the fan?

- **Assumption:** line held low = stopped.
- **Evidence:** chriskoz (stock "speed 0" = 0 µs high time); coofercat
  (speed 0 → 0 tach pulses, USB-C model).
- **Check:** M4, bench B7. If not: OFF = minimum speed; options in FAQ.

### ASM-6. Tach output

- **Assumption:** none made. The input accepts open collector or push-pull,
  0–12 V, any pulses per revolution; default 2 PPR only scales the RPM
  number.
- **Evidence:** **no source found** for a tach on the 4-pin port (one
  builder lists pin 1 as "not used"); the USB-C model has a tach on D+.
- **Check:** M5, bench B5. Without a tach: RPM 0, ACT `--%`, NO TACH.

### ASM-7. OLED module

- **Assumption:** SH1106, I²C (not SPI), address 0x3C, 3.3 V supply,
  EC11 20 pulses / 20 detents, keys switch to GND, pin order varies.
- **Evidence:** AITRIP listing/manual (manuals.plus, ASIN B0F87DZ51P),
  makerselectronics and bitsandparts listings. Some generic manuals say
  SSD1306 or SH1116, or "3.3–5 V".
- **Check:** build step 5 (screen correct; else `OLED_SSD1306 1` or address
  0x3D; encoder direction and edges per detent).

---

## 6. Known limitations and failure modes

| Situation | What happens | Mitigation |
|---|---|---|
| Mains power cut / fan unplugged | Controller loses power; comes back **OFF at 50 %**. **The fan does not restart by itself.** | By requirement. Change deliberately if automatic restart is needed. |
| Controller's 5 V fails while the fan has power | Q1 off, line released; fan most likely **full speed** (H4). | "Fail-ventilating". A fail-off design would need a normally-on pull-down powered from the fan. |
| Speed wire breaks | Line floats → likely full speed; display unaware unless the tach shows it. | Strain relief, cable gland. |
| Tach wire breaks / no tach | RPM 0; `NO TACH` after 8 s; fan still controlled. | — |
| Program hangs in `loop()` or `setup()` | Watchdog interrupt after 2 s: fan stopped, interrupt sources off, sketch restarts OFF **with the speed setting kept**. | Verified in simavr. |
| Program hangs with interrupts disabled | Second timeout (4 s) → hardware reset; fan held off by R4. Old-bootloader Nanos may then reset-loop until power-cycled (fan stays off). | Datasheet behaviour; bench W2. |
| Supply dips < 6.2 V for > ~12 ms | 5 V sags; brown-out reset possible; restarts OFF. | C1 hold-up; bench B10. |
| Fan 10 V collapses below ~4 V | Q1 can't be held on; line may rise. Fan's own electronics are also out of spec. | — |
| Fan doesn't stop at 0 % | OFF = minimum speed. | Switch mains (FAQ). |
| Low settings don't start the fan | Fan stalls; NO TACH. | `FAN_DUTY_MIN_PCT` (bench B6). |
| Calibration lost at power-off | ACT `--%` until recalibrated. | Copy `TACH_MAX_RPM` into `config.h`. |
| Wrong `TACH_PULSES_PER_REV` | RPM figure off by a factor; ACT % unaffected. | Optical tachometer (FAQ). |
| `millis()` wrap (49.7 days) | Handled (tested). | — |
| I²C bus stuck, display missing or failing | The firmware enables the `Wire` timeout (off by default in the core), probes the display before `begin()`, and stops drawing at the first timeout. The controller keeps working without the display (knob, button, fan, serial) and re-probes every 5 s. If something still stalled `setup()` or `loop()` for 2 s, the watchdog stops the fan and restarts. | Sim `nodisplay`. |
| Upload or serial-monitor open | Nano resets → fan stops, controller restarts OFF. | Expected (FAQ). |
| Large surge above D2's clamp capability | Could exceed an AMS1117's 15 V absolute maximum. | Residual risk (§2.2). |
| Open-loop control | The knob sets duty, not RPM; ACT shows the result. | Possible extension. |
| Power applied, before the 5 V rail is up | The line is released for an unmeasured few ms to tens of ms; R4 can't act without 5 V. | Not expected to move a fan (stock ramps take ~2 s); measured by bench A4 (scope). |
| Reset cause on Optiboot Nanos | Optiboot clears MCUSR and passes nothing on, so `reset=` reads 0 after hardware resets. Watchdog-interrupt restarts are still reported (own .noinit marker). | Cosmetic. |
| +10 V reaches the PWM wire (mis-wiring) | Q1 (on by default) shorts it; no fuse in that path. | Pre-connection checks M1–M4 identify every pin first. |
| ACT % at first use | Shows `--%` until a calibration in this power session, or `TACH_MAX_RPM` set in `config.h`. | By design (no RPM figure is published). |

---

## 7. Independent review: findings and fixes

**How the review was done.** After all deliverables were written, a
separate agent that had not written any of the work reviewed the whole
repository against TASK.md and the addendum. It ran the host tests, compiled
the firmware for the Nano, checked links, viewed the rendered schematic and
wiring view, and read every document and source file. It reported 20
findings (7 major, 13 minor). Each was checked against the source before
being fixed; all 20 were confirmed.

| # | Sev. | Finding | Resolution |
|---|---|---|---|
| 1 | Major | The I²C timeout added to `app.cpp` never compiled in: `WIRE_HAS_TIMEOUT` isn't defined by core 1.8.6. A stuck bus could hang `setup()` before the watchdog started. Also `twi_init()` turns the 5 V pull-ups back on after a timeout. | `Wire.setWireTimeout(25000, true)` is called unconditionally (core 1.8.6 has it; host stub records it, Sim checks it). The watchdog now starts at the top of `setup()`. The pull-up concern disappeared with U4 (finding 6): A4/A5 are on the 5 V side. |
| 2 | Major | D2 was a plain `INPUT`, floating in build step 5 (R6 not fitted yet), so noise could fake RPM. | D2 is `INPUT_PULLUP` (Sim checks it); the tach low level was recalculated with the extra pull-up (§2.7: ≤ 1.0 V). |
| 3 | Major | No check that the Nano is the right way round in its socket; reversed, VIN (+10 V) lands on D12. | README step 5 has an orientation check (VIN, GND, 5V over the holes wired in steps 2 and 4) before power is applied. |
| 4 | Major | Addendum §3: no procedure to tell PWM from a 0–10 V input, to find pulses per revolution, or to confirm the OLED driver/address. | README pre-connection: **M4b** (in-between DC level test and what to change), **M5b** (push-pull vs open collector; PPR from an optical tachometer or slow-motion video), **M7** (module checks). The firmware now reports on the console which I²C address answers; step 5 checks the picture for the SSD1306 symptom. |
| 5 | Major | Claims stated without a source: 33 % minimum duty, 0 tach pulses at speed 0, "grounds and opens", encoder pins not connected to the SH1106, boot window "a fraction of a millisecond". | The first three now cite chriskoz/AutoFan or coofercat (USB-C model, stated). The encoder claim is marked as an assumption with check M7 (PINOUT, `app.cpp` comment). The boot window is now described as unmeasured with an estimate and a scope measurement in bench A4 (FAQ, §6). |
| 6 | Major | SDA/SCL pulled up to 3.3 V only, but the ATmega328P TWI needs V<sub>IH</sub> ≥ 0.7 V<sub>CC</sub> = 3.5 V. | **Hardware change:** U4 BSS138 level-shifter module added (schematic, wiring view, BOM, PINOUT, README step 4, FAQ entry, §2.8). |
| 7 | Major | Requirement IDs in BENCH_TEST (R6, D5 …) clash with part references. | Renamed REQ-n / DES-n (and DOC, ASM, TST, VER, SCH, LAY, CHK in this report). |
| 8 | Minor | Optiboot clears MCUSR, so `reset=` is 0 on real Nanos and the interrupts-off test guard never trips (repeats every ~19 s); an 8-bit marker gives a 1/256 false "restarted" at power-up. | Confirmed in `bootloaders/optiboot/optiboot.c` (`MCUSR = 0`, no flags passed). The soft-restart marker is now 32 bits (plus a checked copy of the setting); the test guard uses its own .noinit marker; the limitation is documented (§6). |
| 9 | Minor | `jmp 0` doesn't reset PCICR/PCMSK2, EIMSK, TWCR, so ISRs could run against freshly zeroed state. | The watchdog ISR now clears TWCR, PCICR, EIMSK, UCSR0B and TIMSK2 before jumping. |
| 10 | Minor | A watchdog restart lost the setting although power stayed on (brief: setting persists while powered). | The ISR saves the setting in .noinit RAM with a check byte; `setup()` restores it (fan still OFF). simavr test: 37 % before the hang, 37 % after. |
| 11 | Minor | Calibration code accepted a 20 % total spread while the docs said "every sample within ±10 %". | Code changed to match the docs: each sample within ±10 % of the average. New unit test with one sample about 17 % below the average (rejected). |
| 12 | Minor | R4 drawn on the D9 side of R3 in the schematic but described as "Q1 gate ↔ +5V" elsewhere. | All documents now say "from the D9 end of R3 to +5V", matching the schematic. |
| 13 | Minor | Tach clamp current stated as < 5 mA, ≤ 7 mA and 6.7 mA in different places. | 6.7 mA (at 12 V) everywhere. |
| 14 | Minor | BENCH dummy-load figures wrong (LINE with LED, LED current, F1 trip impossible at 150 mA limit, 3.6 vs 3.7 V, wrong test IDs). | Corrected; A3 now stops at 11.5 V and checks D2 does **not** conduct. |
| 15 | Minor | "Four tabs" (five listed); stale size figures; U8g2 version note; OLED wire length 30 vs 50 cm. | Fixed; sizes say "give or take a few bytes"; libraries.txt explains what was verified; 30 cm everywhere. |
| 16 | Minor | M3b had no upper bound: a stiff source on pin 2 would overload M4's 100 Ω resistor. | M3b: stop if the reading is above 0.9 × M1. |
| 17 | Minor | FAQ overclaimed that D1 protects against a mis-wired cable. | Now limited to the power pins; the PWM-wire case is stated (§6). |
| 18 | Minor | Raw and conditioned tach wires both green in the wiring view. | Conditioned tach is light green, labelled "TACH OUT → D2". |
| 19 | Minor | Enclosure size; a source URL labelled "128x160"; P6KE13A clamp above AMS1117 15 V. | Hammond 1591XXSSBK is about 112 × 85 × 45 mm per RS Components' listing (corrected, "check the maker's drawing"); that source link removed; the clamp caveat was already in §2.2 and is now also in §6. |
| 20 | Minor | Diagnostics text wrong with `FAN_PWM_INVERTED 0`; ACT needs calibration (trace as partial); enclosure step without a check; config block in `config.h` not the `.ino`. | Diagnostics text follows the polarity; REQ-5 notes the calibration; README step 8 (enclosure) has a check; DES-12 states the config-file choice. |

**Issues found by the author during the work** (before or alongside the
review):

| # | Issue | Resolution |
|---|---|---|
| S-1 | 4.7 kΩ I²C pull-ups give ≈ 400 ns rise time with 100 pF, over the 300 ns limit at 400 kHz. | 2.2 kΩ (then U4, finding 6). |
| S-2 | The first real AVR build overflowed RAM: the full 1 KB frame buffer left 4 bytes, because string literals live in RAM on AVR. The earlier "1.45 KB" estimate was wrong. | Page buffer, strings in flash (`PSTR`/`F()`), `_tr` fonts. |
| S-3 | The Arduino IDE generates function prototypes with ctags; a non-Arduino ctags produced broken ones. | All code lives in `.cpp`/`.h`; the `.ino` has none, so IDE and host builds compile identical source. |
| S-4 | "Wire uses a timeout by default" was written in a draft of this report; the core source shows it is off by default. | Firmware enables it (finding 1). |
| S-5 | The old Nano bootloader reset-loops after a hardware watchdog reset (SpenceKonde Ref_Reset.md; arduino/Arduino#4492). | Interrupt-first watchdog with `jmp 0` restart. |
| S-6 | simavr does not model "reset if the watchdog interrupt is not executed". | That case rests on the datasheet; simavr run marked "info only"; bench W2 tests it on hardware. |
| S-7 | README build order had the enclosure between "fan interface" and "first power-up". | Enclosure moved to step 8, after the first power-up. |
| S-8 | In-circuit diode test of D1 is misleading (C1 charges through it). | D1/D2 tested before soldering. |
| S-9 | Expected VIN readings ignored the PTC's resistance range. | Ranges widened (loaded: M1 − 0.2…0.7 V; unloaded: − 0.05…0.3 V). |

**Second independent review (of the fixes).** A new agent that had written
none of the work reviewed the fix commit: it checked the `.init3` code in
the disassembly (runs after `__zero_reg__`/SP set-up, falls through into
`__do_copy_data`, `.noinit` sits below `__heap_start`), the watchdog ISR,
the U4 connections and arithmetic, and the new README checks. It confirmed
those and reported one new major problem caused by a fix, plus five minor
ones:

| # | Sev. | Finding | Resolution |
|---|---|---|---|
| 2-1 | Major | Starting the watchdog at the top of `setup()` (fix 1) meant a stuck I²C bus made `oled.begin()` take ≈ 4 s of 25 ms timeouts: endless watchdog restarts, controller unusable (fan safely OFF). | Display is driven only while it answers: probe before `begin()`, timeout check after every page, re-probe every 5 s; controller fully usable without a display. New Sim scenario `nodisplay`. §2.8, §2.9, §6 corrected. |
| 2-2 | Minor | M4b's RC-filter fallback (10 kΩ series) would stop 0 %/OFF from stopping the fan. | Series R ≤ 1/20 of the measured pull-up, R × C ≥ 2.5 ms; re-run M4, B4, B7. |
| 2-3 | Minor | M4b's test voltage could be near 9 V, so an analogue input would look like "full speed". | M4b now uses a resistor ≈ the measured pull-up, putting the line near M1/2. |
| 2-4 | Minor | I²C low-side sink current understated (1.9 mA); with module pull-ups it could exceed 3 mA. | Restated as ≈ 2.5 mA; R1/R2 are left out if M7 finds ≤ 4.7 kΩ pull-ups on the module (README M7, step 4, PINOUT). |
| 2-5 | Minor | Stale text: setup-hang wording, D2 `INPUT`, R4 "gate pull-up" in three places, DES-4 bench references. | All corrected. |
| 2-6 | Minor | M7 assumed encoder contacts read open at rest. | "Toggles between OL and ~0 Ω while turning". |

After these fixes the host tests, pin cross-check, link check, both Nano
builds, the Wokwi build and the simavr run were repeated (§8). The second
round of fixes was checked by these re-runs, not by a third review.

---

## 8. Recorded test and build output

All runs on 2026-10-28, on the final Rev B sources.

### 8.1–8.2 Host tests: `make -C test`

Logic unit tests (built as C++11 and C++17, C++17 run shown), firmware
simulation scenarios, the no-EEPROM check and the pin cross-check:

```
no-eeprom: firmware has no EEPROM access
pin cross-check: 72 checks, 0 mismatches
../build/test_fan_logic_cxx11 > /dev/null
../build/test_fan_logic
- decoder_counts_one_detent_per_full_cycle
- decoder_emits_only_at_rest_position
- decoder_ignores_bounce_and_aborted_turns
- decoder_discards_invalid_double_jump
- decoder_reset_resynchronises
- button_short_press_after_debounce
- button_ignores_glitches
- button_long_press_fires_once_and_suppresses_short
- button_suppressed_press_produces_nothing
- button_bounce_gives_one_press
- detents_step_accelerate_and_clamp
- setting_to_duty_mapping
- gate_drive_inverted
- gate_drive_non_inverted
- timer1_top
- tach_estimates_rpm_from_periods
- tach_reports_zero_after_timeout
- tach_pulses_per_rev
- tach_survives_micros_rollover
- smoothing
- rpm_percent
- decoder_half_step_detents
- decoder_rapid_direction_changes
- detents_at_limits
- duty_mapping_guards
- polarity_inversion
- tach_fault_detection
- rpm_percent_max_not_calibrated
- controller_power_up_state
- controller_on_off_keeps_setting
- controller_min_duty_mapping
- controller_calibration_success
- controller_calibration_rejects_unsteady_or_missing
- controller_calibration_rule_is_plus_minus_10_percent
- controller_calibration_guards_and_cancel
- controller_screens
- command_parser
fan_logic: 1113 checks, 0 failures
boot1: 742 frames layout-checked
boot1: 850 checks, 0 failures
powercycle: 10 frames layout-checked
powercycle: 23 checks, 0 failures
serial: 30 frames layout-checked
serial: 59 checks, 0 failures
oledaddr: 5 frames layout-checked
oledaddr: 15 checks, 0 failures
nodisplay: 0 frames layout-checked
nodisplay: 20 checks, 0 failures
diagboot: 43 frames layout-checked
diagboot: 55 checks, 0 failures
wrap: 180 frames layout-checked
wrap: 197 checks, 0 failures
calfail: 215 frames layout-checked
calfail: 232 checks, 0 failures
ALL TESTS PASSED
```

### 8.3 AVR simulation: `sh test/avr/run_simavr.sh`

```
building...
running (simulated time is slower than real time)...
  ok   normal: Cloudline controller ready. Fan OFF
  ok   normal: on=0 set=50% duty=0.0%
  ok   normal: no 'restarted by the watchdog'
  ok   hang: TEST: loop() hangs now
  ok   hang: restarted by the watchdog
  ok   hang: reset=0x80
  ok   hang: on=0 set=37% duty=0.0%
  ok   hangcli: TEST: hang with interrupts off
  info hangcli: no reset (expected: simavr does not model WDIE-then-reset)
logs: /tmp/cloudline-simavr/normal.log /tmp/cloudline-simavr/hang.log /tmp/cloudline-simavr/hangcli.log
SIMAVR TESTS PASSED
```

Serial output of the `normal` build (`TEST_FORCE_DISPLAY` makes the display
code run although simavr has no display; `ram_free_min` is the stack
high-water figure in §2.11):

```
Cloudline controller ready. Fan OFF. Send ? for help
! no I2C device at 0x3C
on=0 set=50% duty=0.0% rpm=0 act=-- max=0(unknown) tach_mHz=0 fault=0 mode=0 ram_free_min=568 reset=0x1
on=0 set=50% duty=0.0% rpm=0 act=-- max=0(unknown) tach_mHz=0 fault=0 mode=0 ram_free_min=561 reset=0x1
on=0 set=50% duty=0.0% rpm=0 act=-- max=0(unknown) tach_mHz=0 fault=0 mode=0 ram_free_min=561 reset=0x1
on=0 set=50% duty=0.0% rpm=0 act=-- max=0(unknown) tach_mHz=0 fault=0 mode=0 ram_free_min=561 reset=0x1
```

Serial output of the `hang` build (watchdog recovery: `reset=0x80` = soft
restart; the 37 % setting survives; the fan is OFF):

```
Cloudline controller ready. Fan OFF. Send ? for help
! no I2C device at 0x3C
on=0 set=50% duty=0.0% rpm=0 act=-- max=0(unknown) tach_mHz=0 fault=0 mode=0 ram_free_min=561 reset=0x1
on=0 set=50% duty=0.0% rpm=0 act=-- max=0(unknown) tach_mHz=0 fault=0 mode=0 ram_free_min=561 reset=0x1
on=0 set=50% duty=0.0% rpm=0 act=-- max=0(unknown) tach_mHz=0 fault=0 mode=0 ram_free_min=561 reset=0x1
TEST: loop() hangs now
Cloudline controller ready. Fan OFF. Send ? for help
! restarted by the watchdog (fan OFF, setting kept)
! no I2C device at 0x3C
on=0 set=37% duty=0.0% rpm=0 act=-- max=0(unknown) tach_mHz=0 fault=0 mode=0 ram_free_min=561 reset=0x80
```

### 8.4 Nano compile (arduino-cli 1.1.1, arduino:avr 1.8.6, avr-gcc 7.3.0, U8g2 2.35.30)

`--warnings all`, processor "ATmega328P" then "ATmega328P (Old Bootloader)":

```
Sketch uses 26236 bytes (85%) of program storage space. Maximum is 30720 bytes.
Global variables use 1287 bytes (62%) of dynamic memory, leaving 761 bytes for local variables. Maximum is 2048 bytes.
(project-file warnings: 0)
Sketch uses 26236 bytes (85%) of program storage space. Maximum is 30720 bytes.
Global variables use 1287 bytes (62%) of dynamic memory, leaving 761 bytes for local variables. Maximum is 2048 bytes.
(project-file warnings: 0)
```

All 7 warnings come from the Arduino core (`new.cpp`) and U8g2 (`mui.c`,
`mui_u8g2.c`, `u8g2_arc.c`); **none from project files**.

Wokwi build (`-DTARGET_WOKWI=1`):

```
Sketch uses 27580 bytes (89%) of program storage space. Maximum is 30720 bytes.
Global variables use 1304 bytes (63%) of dynamic memory, leaving 744 bytes for local variables. Maximum is 2048 bytes.
```

No EEPROM routines in the linked binary (`avr-nm -C … | grep -i eeprom`
lists only the linker's region symbols):

```
00000400 A __EEPROM_REGION_LENGTH__
00810000 N __eeprom_end
```

### 8.5 Pin cross-check: `python3 test/check_pins.py`

```
TACH        config.h        ok       PIN_TACH = 2 (expected 2)
TACH        schematic       ok       [('D2 / INT0', 5)] (expected D2 = pin 5)
TACH        wiring.svg      ok       net TACH_D2 -> ['D2'] (expected D2)
TACH        PINOUT.md       ok       | 5 | **D2** / INT0 | Tach input | R7, R6, D3 anode, D4 cathode, C5 | 
TACH        README.md       ok       socket **D2** (pin 5)
ENC_A       config.h        ok       PIN_ENC_A = 3 (expected 3)
ENC_A       schematic       ok       [('D3', 6)] (expected D3 = pin 6)
ENC_A       schematic wire  ok       D3 wired to ['TRA (enc A)'] (expected TRA)
ENC_A       wiring.svg      ok       net TRA -> ['D3'] (expected D3)
ENC_A       PINOUT.md       ok       | 6 | **D3** / PCINT19 | Encoder A | U3 **TRA** | `PIN_ENC_A 3` | `INP
ENC_A       README.md       ok          | TRA | socket D3 (pin 6)
ENC_B       config.h        ok       PIN_ENC_B = 4 (expected 4)
ENC_B       schematic       ok       [('D4', 7)] (expected D4 = pin 7)
ENC_B       schematic wire  ok       D4 wired to ['TRB (enc B)'] (expected TRB)
ENC_B       wiring.svg      ok       net TRB -> ['D4'] (expected D4)
ENC_B       PINOUT.md       ok       | 7 | **D4** / PCINT20 | Encoder B | U3 **TRB** | `PIN_ENC_B 4` | `INP
ENC_B       README.md       ok          | TRB | socket D4 (pin 7)
ENC_SW      config.h        ok       PIN_ENC_SW = 5 (expected 5)
ENC_SW      schematic       ok       [('D5', 8)] (expected D5 = pin 8)
ENC_SW      schematic wire  ok       D5 wired to ['PSH (push)'] (expected PSH)
ENC_SW      wiring.svg      ok       net PSH -> ['D5'] (expected D5)
ENC_SW      PINOUT.md       ok       | 8 | **D5** | Encoder push switch | U3 **PSH** | `PIN_ENC_SW 5` | `IN
ENC_SW      README.md       ok          | PSH | socket D5 (pin 8)
KEY_CON     config.h        ok       PIN_KEY_CON = 6 (expected 6)
KEY_CON     schematic       ok       [('D6', 9)] (expected D6 = pin 9)
KEY_CON     schematic wire  ok       D6 wired to ['CON / KEY1'] (expected CON)
KEY_CON     wiring.svg      ok       net CON -> ['D6'] (expected D6)
KEY_CON     PINOUT.md       ok       | 9 | **D6** | CON key *(optional)* | U3 **CON** | `PIN_KEY_CON 6` | `
KEY_CON     README.md       ok          | CON | socket D6 (pin 9)
KEY_BAK     config.h        ok       PIN_KEY_BAK = 7 (expected 7)
KEY_BAK     schematic       ok       [('D7', 10)] (expected D7 = pin 10)
KEY_BAK     schematic wire  ok       D7 wired to ['BAK / KEY0'] (expected BAK)
KEY_BAK     wiring.svg      ok       net BAK -> ['D7'] (expected D7)
KEY_BAK     PINOUT.md       ok       | 10 | **D7** | BAK key *(optional)* | U3 **BAK** | `PIN_KEY_BAK 7` | 
KEY_BAK     README.md       ok          | BAK | socket D7 (pin 10)
FAN_PWM     config.h        ok       PIN_FAN_PWM = 9 (expected 9)
FAN_PWM     schematic       ok       [('D9 / OC1A', 12)] (expected D9 = pin 12)
FAN_PWM     wiring.svg      ok       net GATE -> ['D9'] (expected D9)
FAN_PWM     PINOUT.md       ok       | 12 | **D9** / OC1A | Fan PWM (Timer1) | R3 → Q1 gate; R4 to +5V | `P
FAN_PWM     README.md       ok       socket **D9** (pin 12)
STATUS_LED  config.h        ok       PIN_STATUS_LED = 13 (expected 13)
STATUS_LED  PINOUT.md       ok       | 16 | D13 | Status LED (on-board) | — | `PIN_STATUS_LED 13` | `OUTPUT
SDA         schematic       ok       [('A4 / SDA', 23)] (expected A4 = pin 23)
SDA         schematic wire  ok       A4 -> U4 -> SDA
SDA         wiring.svg      ok       net SDA -> ['A4'] (expected A4)
SDA         PINOUT.md       ok       | 23 | **A4** / SDA | I²C data | U4 HV1 → U4 LV1 → U3 **SDA** | fixed 
SDA         README.md       ok          | SDA | U4 LV1 (and R1); U4 HV1 goes to socket A4 (pin 23)
SCL         schematic       ok       [('A5 / SCL', 24)] (expected A5 = pin 24)
SCL         schematic wire  ok       A5 -> U4 -> SCL
SCL         wiring.svg      ok       net SCL -> ['A5'] (expected A5)
SCL         PINOUT.md       ok       | 24 | **A5** / SCL | I²C clock | U4 HV2 → U4 LV2 → U3 **SCL** | fixed
SCL         README.md       ok          | SCL | U4 LV2 (and R2); U4 HV2 goes to socket A5 (pin 24)
VIN         schematic       ok       [('VIN', 30)] (expected VIN = pin 30)
VIN         wiring.svg      ok       net VIN -> ['VIN'] (expected VIN)
VIN         PINOUT.md       ok       | 30 | **VIN** | Power in | **+10V_P** | — | — |
VIN         README.md       ok       **VIN** pin (30)
+5V         schematic       ok       [('+5V', 27)] (expected 5V = pin 27)
+5V         wiring.svg      ok       net +5V -> ['5V'] (expected 5V)
+5V         PINOUT.md       ok       | 27 | **+5V** | Power out (on-board regulator) | U2 VIN, R4, R6, D3 c
+5V         README.md       ok       **+5V** pin (27)
J1.4        schematic       ok       +10V
J1.4        wiring.svg      ok       +10V
J1.4        PINOUT.md       ok       +10V
J1.3        schematic       ok       GND
J1.3        wiring.svg      ok       GND
J1.3        PINOUT.md       ok       GND
J1.2        schematic       ok       PWM
J1.2        wiring.svg      ok       PWM
J1.2        PINOUT.md       ok       PWM
J1.1        schematic       ok       TACH
J1.1        wiring.svg      ok       TACH
J1.1        PINOUT.md       ok       TACH

pin cross-check: 72 checks, 0 mismatches
```

### 8.5b Milling files: `python3 hardware/pcb/fusion/make_fusion.py && python3 hardware/pcb/fusion/check_fusion.py`

```
Isolation lines in the DXF (layers ISO_PASS1..2) computed for a 30 deg V-bit, 0.10 mm tip, 0.20 mm deep:
  cut width 0.207 mm, pass offsets from the copper: 0.104, 0.228 mm
  total path length: pass 1 1614 mm, pass 2 1643 mm
  simulated cut: every net isolated from every other; no copper of any net removed
  board height error +/-0.10 mm (no height map): at 0.10 mm deep the cut is 0.154 mm wide and still isolates every net; at 0.30 mm it is 0.261 mm wide and trims 0.027 mm off copper edges (harmless)
fusion export check: 0 problems
```

The smallest copper gap after the re-route is 0.64 mm (it was 0.41 mm before).

`check_fusion.py` re-imports both STEP files. It checks:

- 45 valid solids;
- the substrate is 100 × 75 × 1.6 mm at the origin, and its volume matches the 99 holes;
- there are 44 copper bodies, one per net (unconnected pads included);
- the copper volume is 20.320 mm³, against 20.311 mm³ from the 2D geometry;
- Z placement;
- the Nano VIN pad is at the right position in both the mirrored and top views.

The isolation check is mutation-tested: running the same paths with a tool
0.06 mm wider is reported as cutting copper. The simulation does not count
slivers under 5 µm, because those come from approximating arcs as polygons.

The tool library is checked by `make_tool_library.py`: every spindle speed is
within the DI 1000's 8 000–20 000 rpm.

Not verified here:

- the import into Fusion 360 (STEP, DXF and tool library);
- the toolpaths and the G-code posted for UCCNC;
- a board actually milled on the M.1000.

### 8.5c Fusion Electronics files: `python3 hardware/pcb/eagle/check_eagle.py`

```
DTD: checked both files
board: 95 pads compared, worst position error 0.0000 mm
board: 100 track segments, identical: True
board: KiCad's connectivity on the imported board: 0 unconnected
board: check_pcb.py on the imported board: pcb netlist check: 20 nets, 71 pads, 0 problems
schematic: 24 parts, 20 nets, 71 pin connections, same netlist as the board: True
eagle export check: 0 problems
```

The `.brd` is read by KiCad's EAGLE importer, which is independent of
`make_eagle.py`. The `.sch` cannot be loaded by `kicad-cli` 7, so it is
checked geometrically instead (see `hardware/pcb/eagle/README.md`).

Mutation test: rotating U2 by 180° and moving one R6 net stub to the other
pin produced 6 problems. Opening the files in Fusion 360 itself is not tested.

### 8.6 Link check

Every relative link and `#anchor` in the Markdown files resolves (0 broken).
