seesharp15/cloudline-fan-controller/CHANGELOG.md

# Changelog

## Independent check of the fab files (2026-11-04)

- New `hardware/pcb/verify_gerbers.py` (standard library only, no KiCad):
  - It reads the Gerber and drill files that go to the fab and rebuilds the
    copper connectivity from them alone. Pads are identified by the X2 tags
    KiCad writes.
  - It compares the result with `check_pcb.py`'s expected netlist, measures
    clearance and edge distance, and checks drill/pad/mask correspondence
    and that the outline forms one closed loop.
  - It was tested with deliberately broken Gerbers: a deleted track, a
    bridging track, copper 0.3 mm from a pad and a missing outline edge
    were each detected.
  - Result on the current (0.6 mm-clearance) board: 20 nets, 71 pads, no
    opens, no shorts, minimum clearance 0.64 mm.
  - It runs as part of `make -C test`.
- A second single-sided board had been designed in a parallel session
  against the earlier circuit (no level shifter, old tach stage). It was
  dropped in favour of this board, which matches the current schematic.

## PCB build guide (2026-11-03)

- `hardware/pcb/README.md` rewritten as the main page for the PCB:
  - the three ways to get a board (mill, order, etch);
  - the milling setup;
  - every file;
  - a walkthrough split into resumable sessions S0–S18, from opening the
    files to a boxed controller. Each session has a start state, steps, a
    checkpoint, and what to do if it goes wrong;
  - a progress log to fill in.
- `hardware/pcb/fusion/README.md` keeps the reference material and points to
  the walkthrough for the steps.

## Rev B PCB, milling and Fusion 360 (2026-11-03)

- **Board re-routed for isolation milling.**
  - Clearance went from 0.35 to 0.6 mm; tracks are routed ≥ 0.69 mm from
    other copper.
  - The smallest gap is now 0.64 mm (it was 0.41 mm). That gap is between
    2.54 mm-pitch header pads.
  - Same placement, still no wire links. DRC is clean and `check_pcb.py`
    passes.
  - Gerbers, drill files and renders were regenerated.
- New `hardware/pcb/fusion/`: files for milling in Fusion 360 on a
  Stepcraft M.1000 (UCCNC, DI 1000 spindle, tool changer). They are
  generated by `make_fusion.py` and `make_tool_library.py`, and checked by
  `check_fusion.py`.
  - STEP model, copper side up, plus a top-view STEP.
  - DXF with two-pass isolation paths for a 30° V-bit, cutting 0.20 mm deep.
    The simulation checks them for a board up to ±0.1 mm off the touch-off
    height, since there is no height map.
  - Drill layers per hole size, and a Fusion tool library (T1–T7).
  - A step-by-step setup and operations guide.
- New `hardware/pcb/eagle/`: the schematic and board as EAGLE 9 `.sch` and
  `.brd`, editable in Fusion Electronics.
  - `make_eagle.py` writes them; `check_eagle.py` checks them.
  - The check validates both files against the DTD and reads the board back
    with KiCad's EAGLE importer: pads, tracks and nets are identical, and
    `check_pcb.py` passes on it.
  - It also checks the schematic's netlist geometrically.

## Rev B PCB (2026-11-03): single-sided printed circuit board

- New `hardware/pcb/`: a 100 × 75 mm board with ONE copper layer (bottom),
  all parts through-hole, no wire links. Generated by `make_pcb.py`
  (placement, netlist and a one-layer grid router). Production package by
  `make_fab.py`: Gerbers (RS-274X) and Excellon drill in an upload-ready zip
  with fab notes, drill map, BOM, 1:1 assembly drawing, toner-transfer
  artwork, renders.
- Independent review of the PCB: no blockers; enclosure size, fab notes,
  F1 footprint, silkscreen size, J2 pads, U4 ground and documentation fixed.
- Checks: KiCad DRC (0 errors, 0 unconnected) and `check_pcb.py`, which
  verifies the copper geometry against PINOUT.md's point-to-point list.
- Fan cable goes into a 4-way screw terminal J2 (1 +10V, 2 TACH, 3 GND,
  4 PWM); the OLED module plugs into two pin headers (J3 keys, J4 power/I2C).
- R5 (not fitted by default) now pulls up to the fan's +10 V before F1 in
  the schematic and PINOUT too, matching the PCB.
- Ceramic capacitors in the BOM changed to TDK FG28 parts with 5 mm lead
  pitch (the KEMET C320 parts listed before have 2.54 mm).
- BOM: the enclosure is now specified by inside size (the box listed before
  couldn't be verified to fit); U4 is the SparkFun BOB-12009 only.

## Rev B (2026-10-28): addendum - documentation, verification and tests

Hardware
- **I²C level shifter U4** (BSS138 module) between the 5 V Nano and the
  3.3 V display: the ATmega's TWI needs 3.5 V for a valid high, which a
  3.3 V pull-up doesn't reach. R1/R2 changed to 2.2 kΩ (rise time at
  400 kHz).
- Tach input redesigned: pulled up to **+5 V** (R6 10 kΩ) behind a 1 kΩ
  series resistor (R7) with BAT85 clamps to +5V and GND (D3, D4) and a
  10 nF filter (C5). Replaces the 2N3904 inverter that pulled the fan's tach
  pin up to 10 V. D2 now never sees more than ~5.3 V, whatever is on J1 pin 1.
- C1 raised from 100 µF to 220 µF for more hold-up during supply dips.
- Schematic regenerated (SVG + PNG) with the J1 mating-face view; new
  wiring view with wire colours (`hardware/wiring.svg`), overview
  illustration, BOM as CSV with part numbers and prices.

Firmware
- First real AVR build (arduino-cli, avr-gcc 7.3.0). It showed that the full
  1 KB frame buffer leaves only 4 bytes of RAM: switched to the 256-byte
  page buffer, moved all UI strings to flash, and use the smaller `_tr`
  fonts. Now 26 236 bytes flash (85 %), 1 287 bytes RAM (62 %).
- **No EEPROM at all.** The calibration result is kept in RAM until
  power-off and printed on the serial console for copying into `config.h`.
  The max RPM defaults to "unknown" (`--%`) because no RPM figure is
  published for the AI-CLS6.
- **Watchdog** added (2 s), using interrupt-then-reset mode: the interrupt
  stops the fan and restarts the sketch without a hardware reset, so it is
  safe on old-bootloader Nanos.
- PWM default changed from 1 kHz to **4 kHz**, matching a builder's
  measurement of the stock controller.
- Serial console (115200 baud): status, on/off, set, calibrate, max RPM;
  reports at start-up which I²C address the display answers on.
- Review fixes: Wire timeout really enabled; watchdog started at the top of
  `setup()`; the watchdog restart switches off all interrupt sources first
  and keeps the speed setting; 32-bit restart marker; D2 internal pull-up;
  calibration rule now exactly "every sample within ±10 %"; diagnostics text
  follows the polarity setting.
- Second review fix: the display is driven only while it answers on I²C
  (probe before `begin()`, timeout check after every page, retry every
  5 s), so a missing display or stuck bus can no longer cause a watchdog
  restart loop.
- Logic restructured: the ON/OFF/setting/calibration state machine and the
  command parser moved into `fan_logic.h` (`fan::Controller`) and are unit
  tested; the hardware glue moved from the `.ino` into `app.cpp`.
- Encoder decoder supports 2 or 4 edges per detent (`ENC_EDGES_PER_DETENT`).
- Compile-time checks on pin and range settings.

Tests
- `tests/` renamed to `test/`. New unit tests for the controller state
  machine, command parser, half-step encoders, rapid reversals, button
  bounce, duty and polarity edge cases, tach fault and the divide-by-zero
  guard (1 113 checks). New simulation scenarios (`powercycle`, `serial`,
  `oledaddr`, `nodisplay`).
- `test/avr/run_simavr.sh` runs the real Nano binary in simavr and checks
  boot and watchdog recovery.
- Wokwi project in `sim/` (prepared, not run).

Documentation
- New README (complete build guide), FAQ, BENCH_TEST, VERIFICATION (report),
  root PINOUT. `docs/DESIGN_NOTES.md`, `docs/VERIFICATION.md` (old procedure)
  and `docs/BOM.md` folded into these.

## Rev A (2026-10-28)

- Initial design: schematic, pinouts, firmware, host tests.
