seesharp15/cloudline-fan-controller/hardware/pcb/fab/assembly_top.pdf

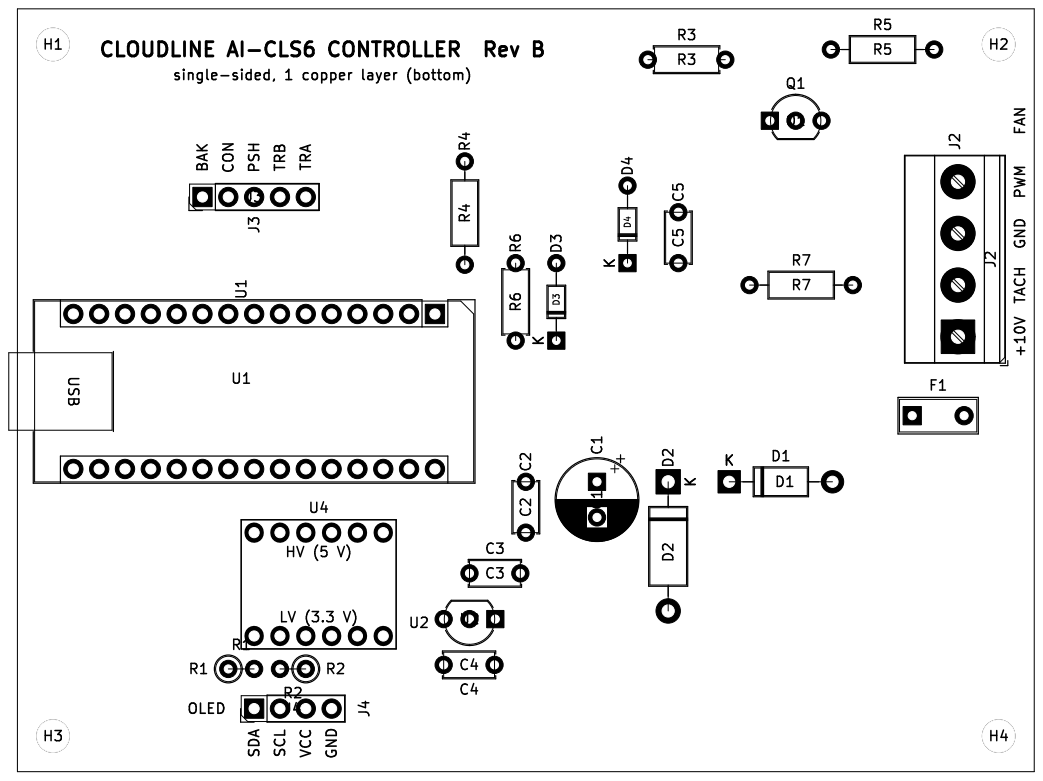
[picture p12: page 1]
