seesharp15/cloudline-fan-controller/hardware/pcb/fab/bottom_copper_toner_transfer_1to1.pdf

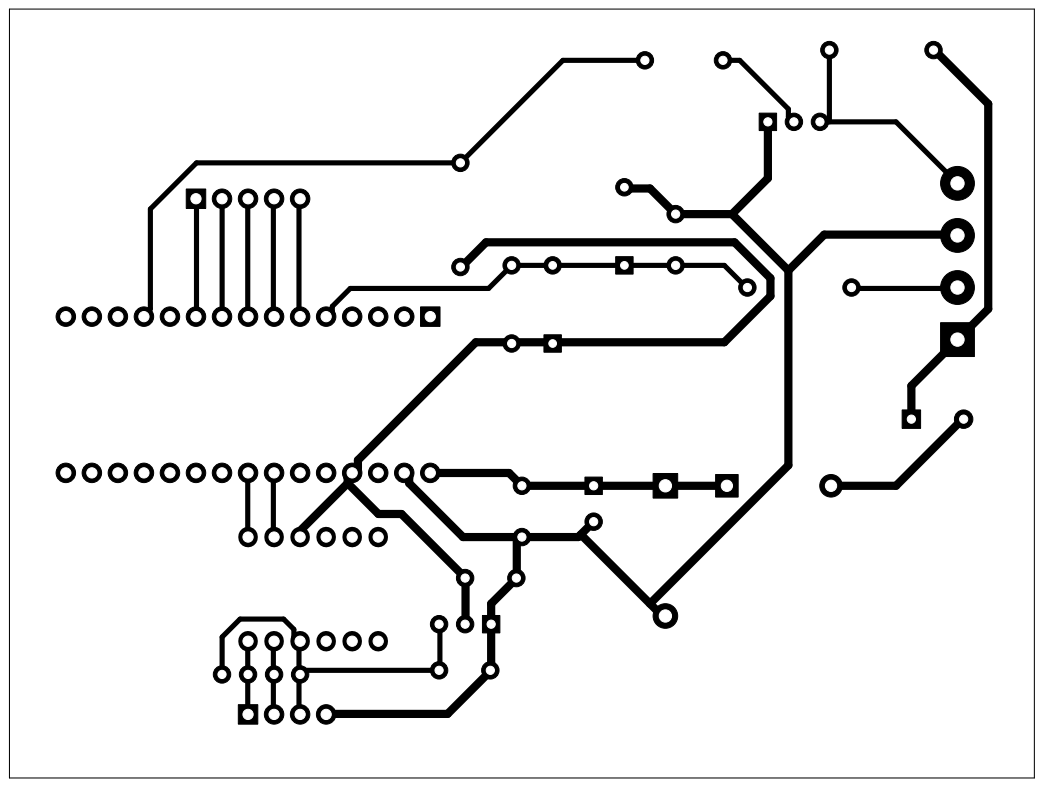
[picture p13: page 1]
