seesharp15/cloudline-fan-controller/hardware/pcb/eagle/cloudline_controller.brd

## EAGLE design hardware/pcb/eagle/cloudline_controller.brd (2026-11-03)

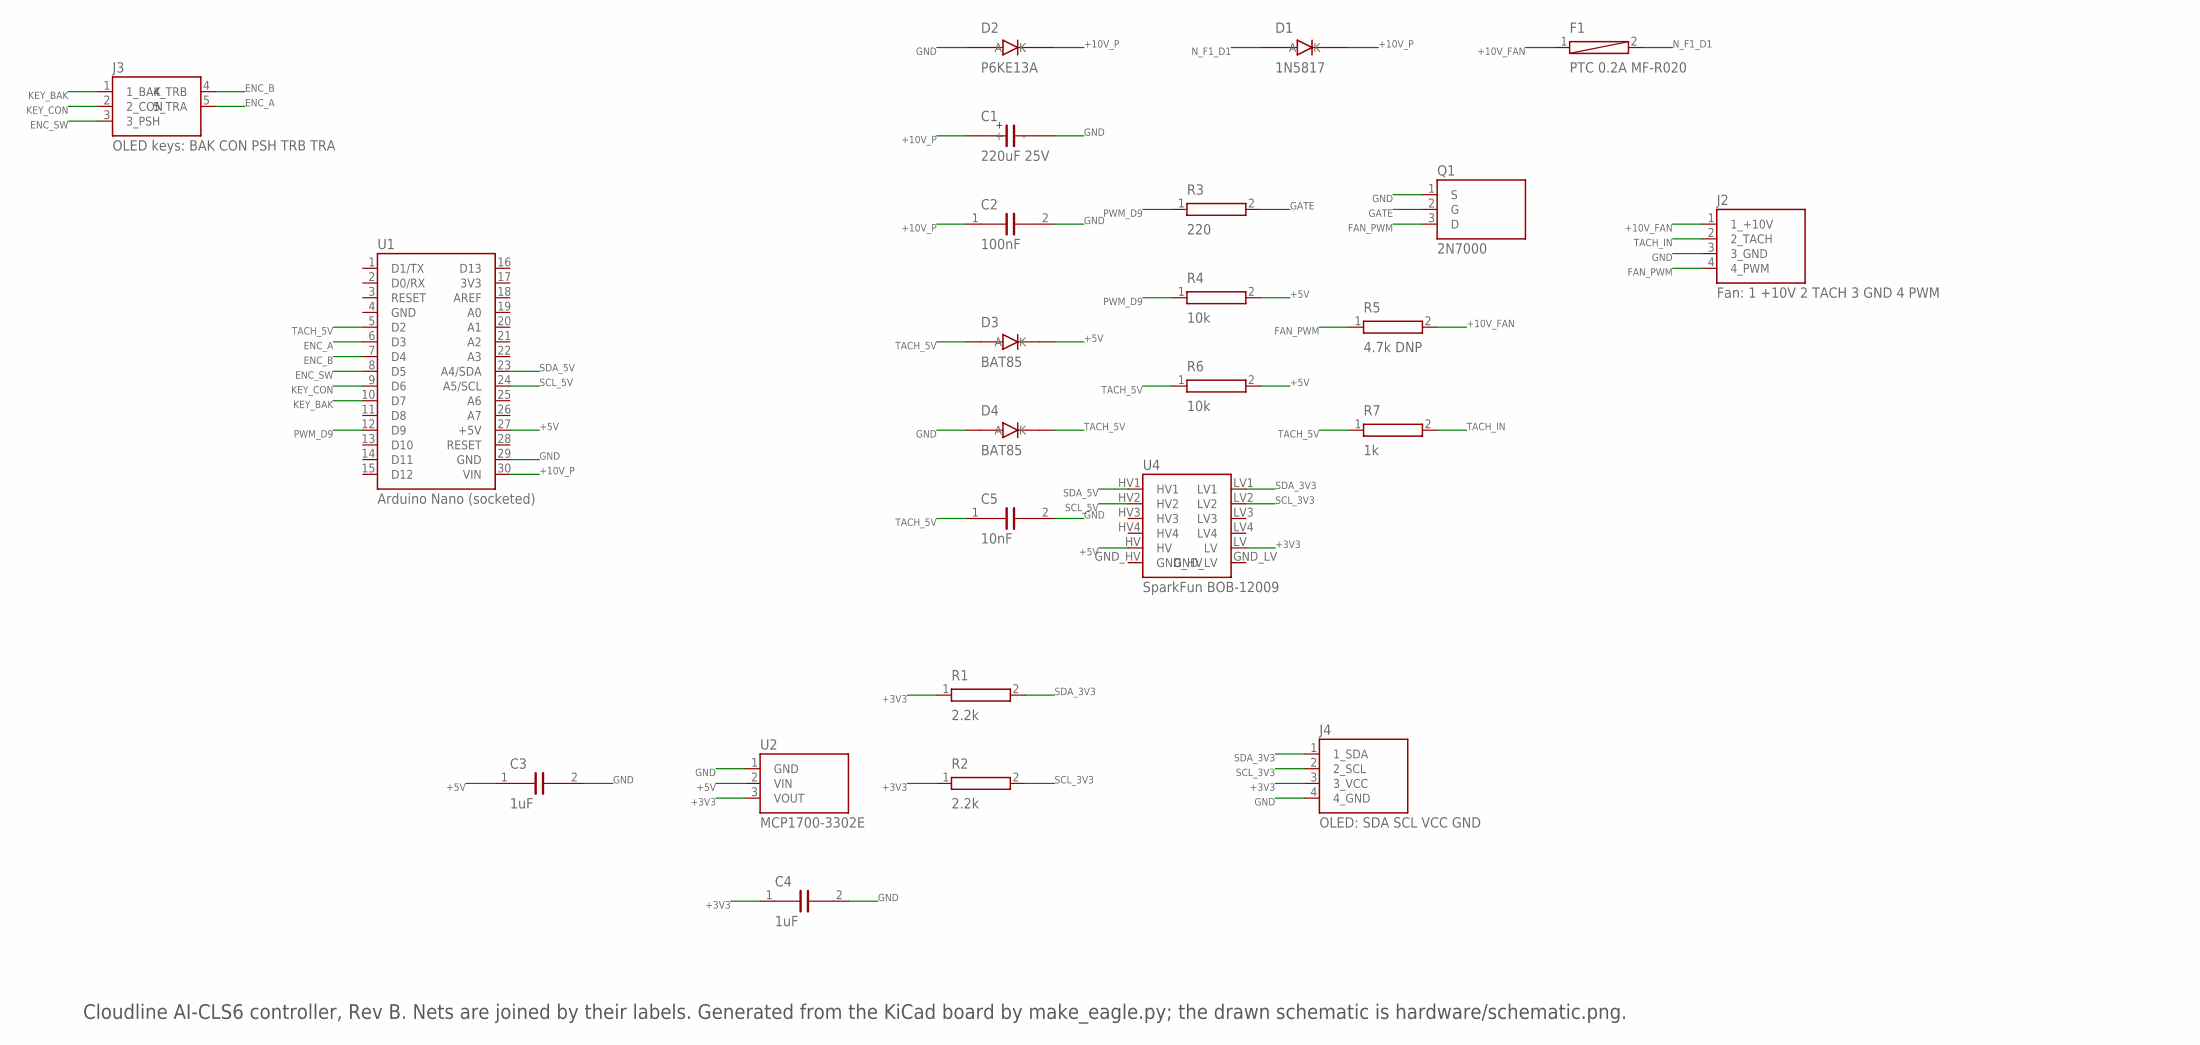
[picture p15: schematic cloudline_controller.sch]

Parts:
C1: 220uF 25V; CP_Radial_D8.0mm_P3.50mm
C2: 100nF; C_Disc_D5.0mm_W2.5mm_P5.00mm
C3, C4: 1uF; C_Disc_D5.0mm_W2.5mm_P5.00mm
C5: 10nF; C_Disc_D5.0mm_W2.5mm_P5.00mm
D1: 1N5817; D_DO-41_SOD81_P10.16mm_Horizontal
D2: P6KE13A; D_DO-15_P12.70mm_Horizontal
D3, D4: BAT85; D_DO-34_SOD68_P7.62mm_Horizontal
F1: PTC 0.2A MF-R020; PTC_Radial_P5.10mm
J2: Fan: 1 +10V 2 TACH 3 GND 4 PWM; TerminalBlock_Phoenix_MKDS-1_5-4-5.08_1x04_P5.08mm_Horizont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
J3: OLED keys: BAK CON PSH TRB TRA; PinHeader_1x05_P2.54mm_Vertical
J4: OLED: SDA SCL VCC GND; PinHeader_1x04_P2.54mm_Vertical
Q1: 2N7000; TO-92_Inline_Wide
R1, R2: 2.2k; R_Axial_DIN0207_L6.3mm_D2.5mm_P2.54mm_Vertical
R3: 220; R_Axial_DIN0207_L6.3mm_D2.5mm_P7.62mm_Horizontal
R4: 10k; R_Axial_DIN0207_L6.3mm_D2.5mm_P10.16mm_Horizontal
R5: 4.7k DNP; R_Axial_DIN0207_L6.3mm_D2.5mm_P10.16mm_Horizontal
R6: 10k; R_Axial_DIN0207_L6.3mm_D2.5mm_P7.62mm_Horizontal
R7: 1k; R_Axial_DIN0207_L6.3mm_D2.5mm_P10.16mm_Horizontal
U1: Arduino Nano (socketed); Arduino_Nano
U2: MCP1700-3302E; TO-92_Inline_Wide
U4: SparkFun BOB-12009; SparkFun_BOB-12009

Connections:
+3V3: C4.1, J4.3 (3_VCC), R1.1, R2.1, U2.3 (VOUT), U4.LV
+5V: C3.1, D3.1 (K), R4.2, R6.2, U1.27 (+5V), U2.2 (VIN), U4.HV
+10V_FAN: F1.1, J2.1 (1_+10V), R5.2
+10V_P: C1.1 (+), C2.1, D1.1 (K), D2.1 (K), U1.30 (VIN)
ENC_A: J3.5 (5_TRA), U1.6 (D3)
ENC_B: J3.4 (4_TRB), U1.7 (D4)
ENC_SW: J3.3 (3_PSH), U1.8 (D5)
FAN_PWM: J2.4 (4_PWM), Q1.3 (D), R5.1
GATE: Q1.2 (G), R3.2
GND: C1.2 (-), C2.2, C3.2, C4.2, C5.2, D2.2 (A), D4.2 (A), J2.3 (3_GND), J4.4 (4_GND), Q1.1 (S), U1.29 (GND), U2.1 (GND)
KEY_BAK: J3.1 (1_BAK), U1.10 (D7)
KEY_CON: J3.2 (2_CON), U1.9 (D6)
N_F1_D1: D1.2 (A), F1.2
PWM_D9: R3.1, R4.1, U1.12 (D9)
SCL_3V3: J4.2 (2_SCL), R2.2, U4.LV2
SCL_5V: U1.24 (A5/SCL), U4.HV2
SDA_3V3: J4.1 (1_SDA), R1.2, U4.LV1
SDA_5V: U1.23 (A4/SDA), U4.HV1
TACH_5V: C5.1, D3.2 (A), D4.1 (K), R6.1, R7.1, U1.5 (D2)
TACH_IN: J2.2 (2_TACH), R7.2

Notes on the sheet:
Cloudline AI-CLS6 controller, Rev B. Nets are joined by their labels. Generated from the KiCad board by make_eagle.py; the drawn schematic is hardware/schematic.png.

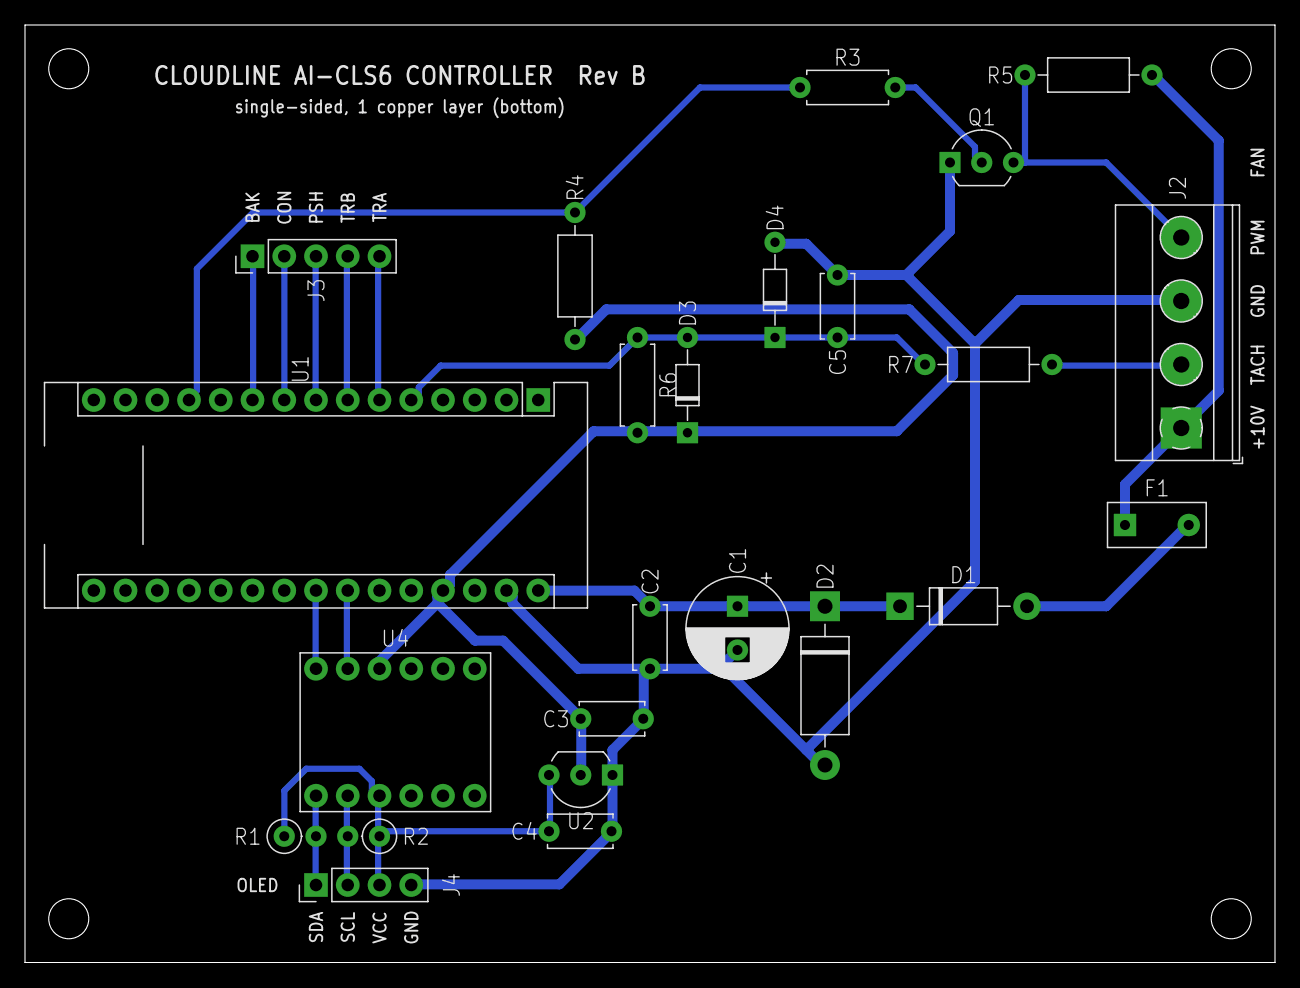
[picture p16: board cloudline_controller.brd from above]

Board: 2 copper layers, 100.0 x 75.0 mm, 24 parts (0 on the bottom side), 20 nets.
