seesharp15/cloudline-fan-controller/(commit log)

2026-10-28 Add task instructions for Cloudline AI-CLS6 fan controller
2026-10-28 Add Cloudline AI-CLS6 controller: schematic, pinouts, firmware, tests
    Arduino Nano + AITRIP 1.3" SH1106 OLED/EC11 controller for the Cloudline
    AI-CLS6 4-pin Molex control port, powered from the fan's 10 V.
    - Hardware: PTC/Schottky/TVS input conditioning into Nano VIN, MCP1700
    3.3 V rail for the OLED, 2N7000 open-drain speed output with a boot-safe
    gate pull-up (fan OFF at power-up), 2N3904 level-safe tach buffer.
    - docs: generated schematic SVG, PINOUT (rails, power budget, wiring
    list), VERIFICATION (measure the fan before connecting, bench bring-up),
    DESIGN_NOTES (calculations, traceability, troubleshooting), BOM.
    - Firmware: interrupt-driven encoder, Timer1 1 kHz PWM, period-base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
2026-10-28 README: add controls, connection caveats, design choices, status, sources
    Bring the details from the design summary into the README: full controls
    table, what is unconfirmed about the fan connector and the one-change fix
    for each surprise, failure behaviour on controller power loss, why the
    3.3 V regulator / R4 / R3 / R8 values were chosen, test coverage and the
    millis() wrap bug the simulation found, project status, and sources.
2026-10-28 Firmware: testable controller, watchdog, no EEPROM, serial console; tests in test/
    - Move the hardware glue into app.cpp; the .ino holds no code so the IDE
    generates no prototypes and host and AVR builds compile the same source.
    - fan::Controller state machine (ON/OFF, setting, calibration) and the
    serial command parser are pure logic and unit-tested.
    - Calibration is kept in RAM only; nothing is written to EEPROM.
    - Watchdog in interrupt-then-reset mode: stops the fan and restarts the
    sketch without a hardware reset (safe on old-bootloader Nanos).
    - Default PWM 4 kHz (stock controller measured ~4 kHz); max RPM unknown
    until calibrated.
    - UI strings in flash and _tr fonts; 256-byte p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
    [Arduino.h, Wire.h, app.cpp, check.h, cloudline_controller.ino, config.h, display_ui.h, fan_logic.h]
2026-10-28 Hardware: 5 V tach front end, wiring diagram, PNG renders, BOM CSV; Wokwi and simavr tests
    Claude-Session: https://claude.ai/code/session_01W97qwMmkSuViuh4WXU3twF
    [bom.csv]
2026-10-28 I2C pull-ups 2.2k, Wire timeout, pin cross-check script, README build order, VERIFICATION draft
    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
    [bom.csv]
2026-10-28 Resolve independent review: I2C level shifter U4, Wire timeout, watchdog restart hardening, docs fixes, VERIFICATION report
    - U4 BSS138 level shifter: ATmega TWI needs 0.7*VCC for a high.
    - Wire timeout enabled (the WIRE_HAS_TIMEOUT guard was never true);
    watchdog starts at the top of setup(); ISR disables interrupt sources
    and keeps the speed setting across the soft restart; 32-bit marker.
    - D2 internal pull-up; calibration rule matches its description.
    - README: Nano orientation check, M3b upper bound, M4b/M5b/M7 checks,
    OLED address report; FAQ/PINOUT sourcing and R4 placement; BENCH IDs
    renamed REQ-/DES-; VERIFICATION.md complete with recorded output.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
    [bom.csv]
2026-10-28 Resolve second review: display driven only while it answers on I2C; M4b/M7 fixes; report updated
    A stuck I2C bus made oled.begin() exceed the 2 s watchdog, causing an
    endless restart loop. The display is now probed before begin(), drawing
    stops at the first I2C timeout (checked after every page), and it is
    re-probed every 5 s; the controller works without a display. New sim
    scenario nodisplay. README M4b filter sizing and test voltage, M7 encoder
    wording and module pull-ups; stale R4/D2 text; VERIFICATION output.
    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
    [Wire.h, app.cpp, test_firmware_sim.cpp]
2026-11-03 Single-sided PCB: KiCad 7 project, router, checks and production files
    - hardware/pcb/make_pcb.py: placement, netlist and a one-layer grid router
    (wire links only where unavoidable: one, W1 on GND). 100 x 75 mm, all
    through-hole, copper on B.Cu only; F.Cu is KiCad's jumper layer.
    - check_pcb.py: copper-geometry connectivity vs PINOUT.md (20 nets, 72 pads,
    0 opens/shorts; mutation-tested). drc.py: KiCad DRC, 0 errors.
    - make_fab.py: Gerbers (RS-274X) + Excellon drill zip, drill map, BOM,
    1:1 assembly drawing, toner-transfer artwork, gerbv read-back renders.
    - R5 pulls up to the fan's +10 V before F1 (schematic/PINOUT match the PCB).
    - BOM: 5 mm-pitch TDK FG28 ceramics; PCB-only parts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
    [bom.csv, cloudline_controller.kicad_pcb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]
2026-11-03 PCB: resolve independent review - no wire links, fab notes, F1 footprint, labels, enclosure spec
    - U4 GND unwired (on the BOB-12009 it connects only to its other GND pin),
    which removes the only wire link: the board is now purely one layer.
    - FAB_NOTES.txt in the zip; Gerber/drill attributes say 1 layer, non-plated.
    - F1: straight 5.1 mm PTC footprint; J2 pads 3.3 mm; connector labels 1.0 mm,
    one per pin (J4 too); R1/R2 side by side; assembly drawing shows pads.
    - BOM/README: enclosure given by required inside size; U4 BOB-12009 only;
    TO-92 lead-bend note. PCB README and VERIFICATION corrected.
    Claude-Session: https://claude.ai/c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
    [bom.csv, cloudline_controller.kicad_pcb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]
2026-11-03 Add Fusion 360 milling files for the Stepcraft M.1000
    STEP model (copper side up) and DXF with verified two-pass isolation
    paths, per-size drill layers and outline, generated from the KiCad
    board by make_fusion.py and checked by check_fusion.py. README covers
    the Fusion CAM setup, feeds and speeds, workholding and open questions.
    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
    [cloudline_pcb_MILL_copper_up.dxf, cloudline_pcb_MILL_copper_up.step, cloudline_pcb_TOPVIEW.step]
2026-11-03 Re-route PCB with 0.6 mm clearance, add UCCNC milling setup and Fusion Electronics files
    - make_pcb.py: 0.6 mm clearance rule, tracks routed 0.75 mm from other
    copper; smallest gap 0.41 -> 0.64 mm (header pad pitch). Still no wire
    links; DRC clean, check_pcb passes. Fab package regenerated.
    - fusion/: isolation at 0.20 mm deep, verified for +/-0.1 mm board height
    error (no height map); Fusion tool library T1-T7 for the DI 1000
    (8-20k rpm); README rewritten for UCCNC, tool changer and one program.
    - eagle/: schematic + board in EAGLE 9 format for Fusion Electronics,
    validated against the DTD and read back with KiCad's EAGLE importer.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
    [cloudline_controller.brd, cloudline_controller.kicad_pcb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]
2026-11-03 PCB README: full project page with a session-by-session build walkthrough
    Sessions S0-S18 from opening the files to a boxed controller, each with
    a start state, steps, a checkpoint and recovery notes; Fusion versions
    and per-tool NC files make every machine session resumable. Fusion
    README now points to the walkthrough for the steps.
    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
2026-11-04 Add independent check of the PCB fab files (verify_gerbers.py)
    check_pcb.py verifies the KiCad board; this verifies the Gerber and
    drill files that actually go to the fab, with no KiCad dependency.
    It rebuilds copper connectivity from flashed pads and drawn tracks
    (pads identified by KiCad's X2 TO.P attributes), compares it with
    check_pcb.py's expected netlist, and measures clearance, edge distance,
    annular ring, drill/pad/mask correspondence and outline closure.
    Mutation-tested: a deleted track, a bridging track, copper 0.3 mm from
    a pad and a missing outline edge are each reported. Current board:
    20 nets, 71 pads, no opens, no shorts, minimum clearance 0.64 mm
    (rule 0.6 mm). Runs as part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
